hongphucbk/lvthacsi/09. Present/20190629_163446.jpg

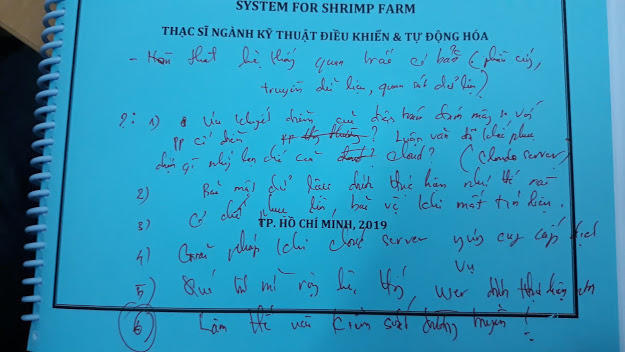
09. Present/20190629_163446.jpg
