hongphucbk/lvthacsi/07. Drawing/BV06.pdf

1 2 3 4 5 6 7 8 1 3 2 FEDCA CBA 4 5 7 6 FE 8 CENINTEC Ngày: 23.08.2018 1:1 MÁY ĐO eAQUA Thiết kế Số S.lg Vẽ Duyệt Số tài liệu Chữ kí Ngày Tờ: 06 Số tờ: 08 Dấu Khối lượng Tỉ lệ Kiểm tra 1 B STT Kí hiệu Tên gọi S.lg Vật liệu Ghi chú L.Đ.CẨN L.Đ.CẨN LÂM NY LÂM NY N1 hoạt động Đèn báo Còi hú Đèn lỗi

# DenHD

Đèn lỗi,Còi sensor độ mặn | pin 1 pin 2 | +24V AI2+ sensor pH | đỏ đen | -12V ⁺¹²V

# D1 sensor pH

D0 sensor pH xanh trắng | ong cấp cho cảm biến pH Note:+12V -12V lấy từ nguồn tổ | PLC Note:+24V lấy từ nguồn 24V của
