hongphucbk/lvthacsi/02. Document Soft/Config.docx

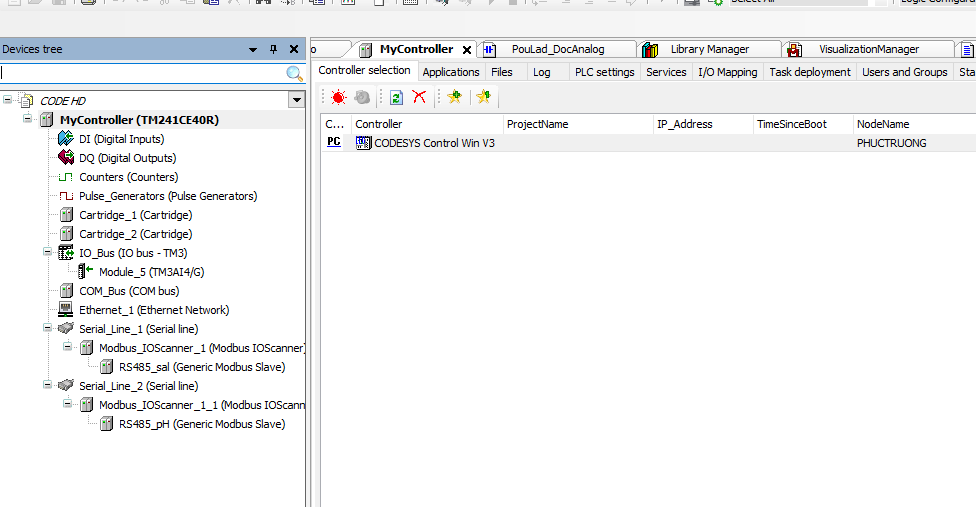
[picture p93: figure]
