hongphucbk/lvthacsi/07. Drawing/BV08.pdf

1 2 3 4 5 6 7 8 1 3 2 FCA CBA 4 5 7 6 FED 8 CENINTEC Ngày: 23.08.2018 1:1 MÁY ĐO eAQUA Thiết kế Số S.lg Vẽ Duyệt Số tài liệu Chữ kí Ngày Tờ: 08 Số tờ: 08 Dấu Khối lượng Tỉ lệ Kiểm tra 1 B STT Kí hiệu Tên gọi S.lg Vật liệu Ghi chú 121110090807060504030201Domino 1 121110090807060504030201Domino 2 VU VU CB_ap CB_ap 0VDC(24) +24VDC 0VDC(24) +24VDC Van XacNhan XacNhan đo 1 đo 1 Van đo 2 Van đo 2 Van đo 5 Van đo 4 Van đo 3 Van đo 5 Van đo 4 Van đo 3 Van Van cấp Van mồi Van đo 8 Van đo 7 Van đo 6 Van rửa Van xả rửa Van xảVan cấp Van mồi Van đo 18 Van đo 7 Van đo 6 Van N0.0 N0 L0.0 L0 L1N1 L1N1 L.Đ.CẨN L.Đ.CẨN LÂM NY LÂM NY domino cho phù hợp. domino,tùy vào cách đi dây mà sử dụng Note: Không nhất thiết phải đấu dây theo

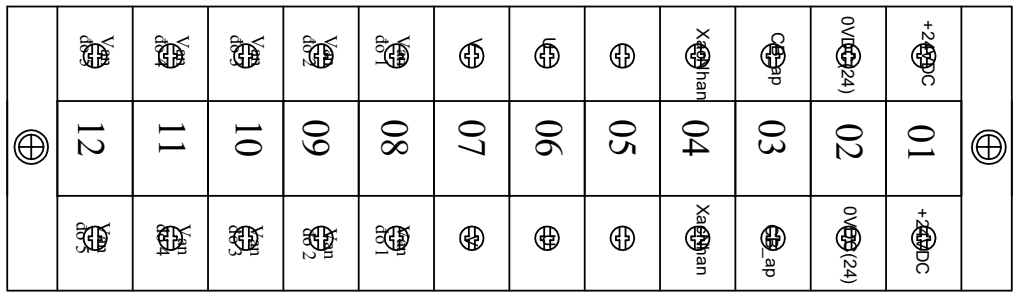
[picture p94: figure]
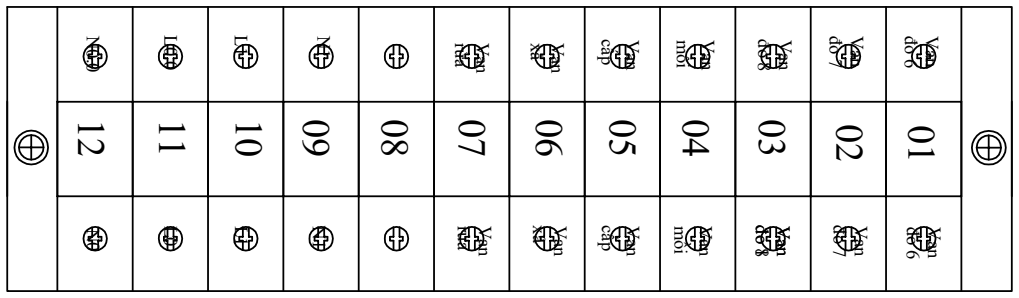
[picture p95: figure]
