hongphucbk/lvthacsi/05. Reports/Thong tin tai khoan.xlsx

MÁY ĐO | IP | WIFI | WIFI | Web điều khiển | App giám sát EQUA | Web giám sát | Phần mềm nuôi tôm
EQUA | 192.168.1.125 | TRANG TRẠI | 192.168.1.1 pass: 12345678 | http://192.168.1.125:8080/maydo.htm | CÓ | http://14.161.37.163:35000/home/ Admin2 pass 123 (http://14.161.37.163:35000/home/%20%20Admin2%20pass%20123)
DCSELAB | 192.168.1.125 | DCSELAB | 192.168.1.1 pass: 12345678 | http://192.168.1.125:8080/dcselab.htm |  |  | dcselab / 123
