hongphucbk/lvthacsi/05. Reports/Do Nh4.JPG

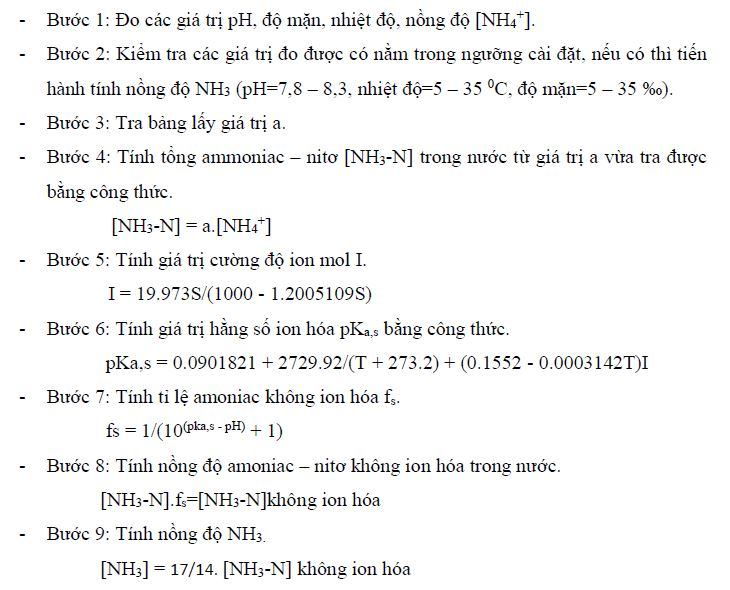
05. Reports/Do Nh4.JPG
