hongphucbk/lvthacsi/(list of files, cad)

Other CAD files:
07. Drawing/bv may do 2652018/MD_MD_7.dwg
07. Drawing/Bản vẽ 26042018/Drumfilter 2d_DR(Cụm động cơ) 03.03.dwg
07. Drawing/bv may do 2652018/MD_MD_5.dwg
07. Drawing/Bản vẽ 26042018/Drumfilter 2d_DR(Cụm động cơ) 03.01.dwg
07. Drawing/bv may do 2652018/MD_MD_3.dwg
07. Drawing/Bản vẽ 26042018/Drumfilter 2d_DR(Cụm khung đỡ và máng cấp thoát) 05.01.dwg
07. Drawing/bv may do 2652018/ban ve tu do.dwg
07. Drawing/Bản vẽ 26042018/Drumfilter 2d_DR(Cụm bơm) 06.00.dwg
07. Drawing/bv may do 2652018/MD_MD_8.dwg
07. Drawing/Bản vẽ 26042018/Drumfilter 2d_DR(Cụm động cơ) 03.02.dwg
07. Drawing/bv may do 2652018/MD_MD_2.dwg
07. Drawing/Bản vẽ 26042018/Drumfilter 2d_DR(Nắp đây) 02.04.dwg
07. Drawing/bv may do 2652018/MD_MD_4.dwg
07. Drawing/Bản vẽ 26042018/Drumfilter 2d_DR(khung) 01.01.dwg
07. Drawing/bv may do 2652018/MD_MD_6.dwg
07. Drawing/Bản vẽ 26042018/Drumfilter 2d_DR(Nắp đây) 02.01.dwg
07. Drawing/bv may do 2652018/MD_MD_1.dwg
07. Drawing/Bản vẽ 26042018/Drumfilter 2d_DR(Cụm động cơ) 03.00.dwg
07. Drawing/Bản vẽ 26042018/Drumfilter 2d_DR(Cụm khung đỡ và máng cấp thoát) 05.04.dwg
07. Drawing/Bản vẽ 26042018/Drumfilter 2d_DR(Nắp đây) 02.02.dwg
07. Drawing/Bản vẽ 26042018/Drumfilter 2d_DR(Nắp đây) 02.03.dwg
07. Drawing/Bản vẽ 26042018/Drumfilter 2d_DR(Khung) 01.00.dwg
07. Drawing/Bản vẽ 26042018/Drumfilter 2d_DR(Cụm trống lọc) 04.00.dwg
07. Drawing/Bản vẽ 26042018/Drumfilter 2d_DR(Cụm khung đỡ và máng cấp thoát) 05.05.dwg
07. Drawing/Bản vẽ 26042018/Drumfilter 2d_DR(Cụm bơm) 06.01.dwg
07. Drawing/Bản vẽ 26042018/Drumfilter 2d_DR(DRUMFILTER) 0.00.dwg
07. Drawing/Bản vẽ 26042018/Drumfilter 2d_DR(Cụm khung đỡ và máng cấp thoát) 05.03.dwg
07. Drawing/Bản vẽ 26042018/Drumfilter 2d_DR(Khung) 01.02.dwg
07. Drawing/Bản vẽ 26042018/Drumfilter 2d_DR(Khung) 01.03.dwg
07. Drawing/Bản vẽ 26042018/Drumfilter 2d_DR(Cụm khung đỡ và máng cấp thoát) 05.00.dwg
