hongphucbk/lvthacsi/07. Drawing/BV02.pdf

D0 sensor pH số 5 là D0 của sensor độ mặn. là D1 của sensor độ mặn,chân RJ45 là cáp ethenet chân số 4 | NC nút dừng khẩn Q7 Q6 Q5 Q4 NC COM0 | Q3 Q2 Q1 Q0 TM2DRA8RT | COM1 | L1.1 Van đo 12 Van đo 11 Van đo 10 Van đo 9

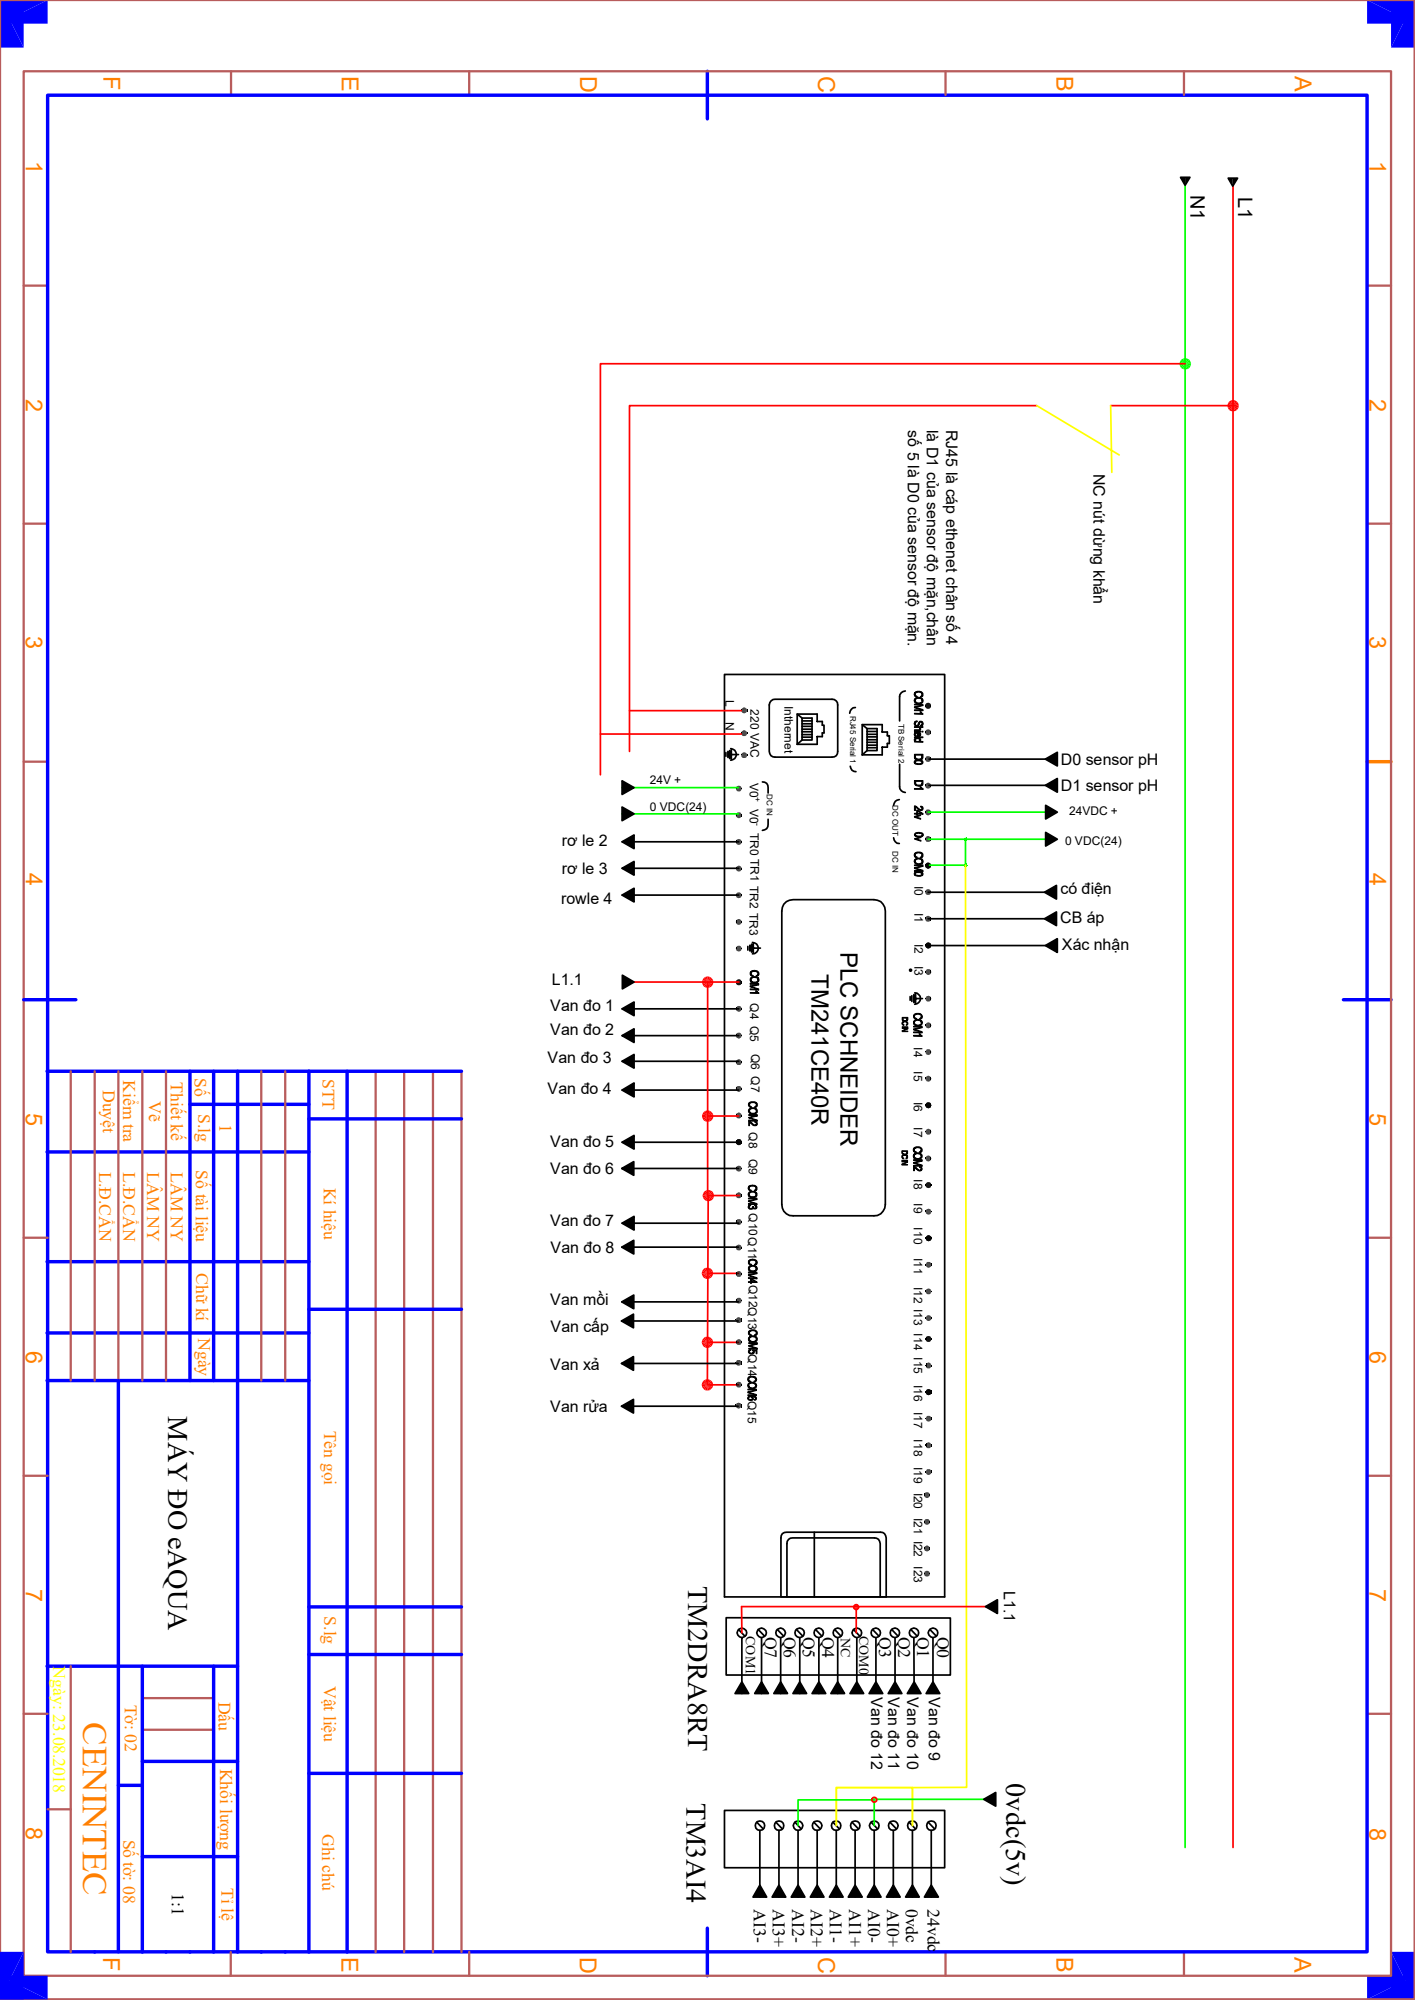
[picture p97: page 1]

1 2 3 4 5 6 7 8 1 3 2 FEDCA CBA 4 5 7 6 FED 8 CENINTEC Ngày: 23.08.2018 1:1 MÁY ĐO eAQUA Thiết kế Số S.lg Vẽ Duyệt Số tài liệu Chữ kí Ngày Tờ: 02 Số tờ: 08 Dấu Khối lượng Tỉ lệ Kiểm tra 1 B STT Kí hiệu Tên gọi S.lg Vật liệu Ghi chú L.Đ.CẨN L.Đ.CẨN LÂM NY LÂM NY L1 PLC SCHNEIDER TM241CE40R V0+ V0- N1
