hongphucbk/lvthacsi/07. Drawing/BV03.pdf

rơ le 2 | L0N0 | RL3
rơ le 4 RL1 | RLNK1

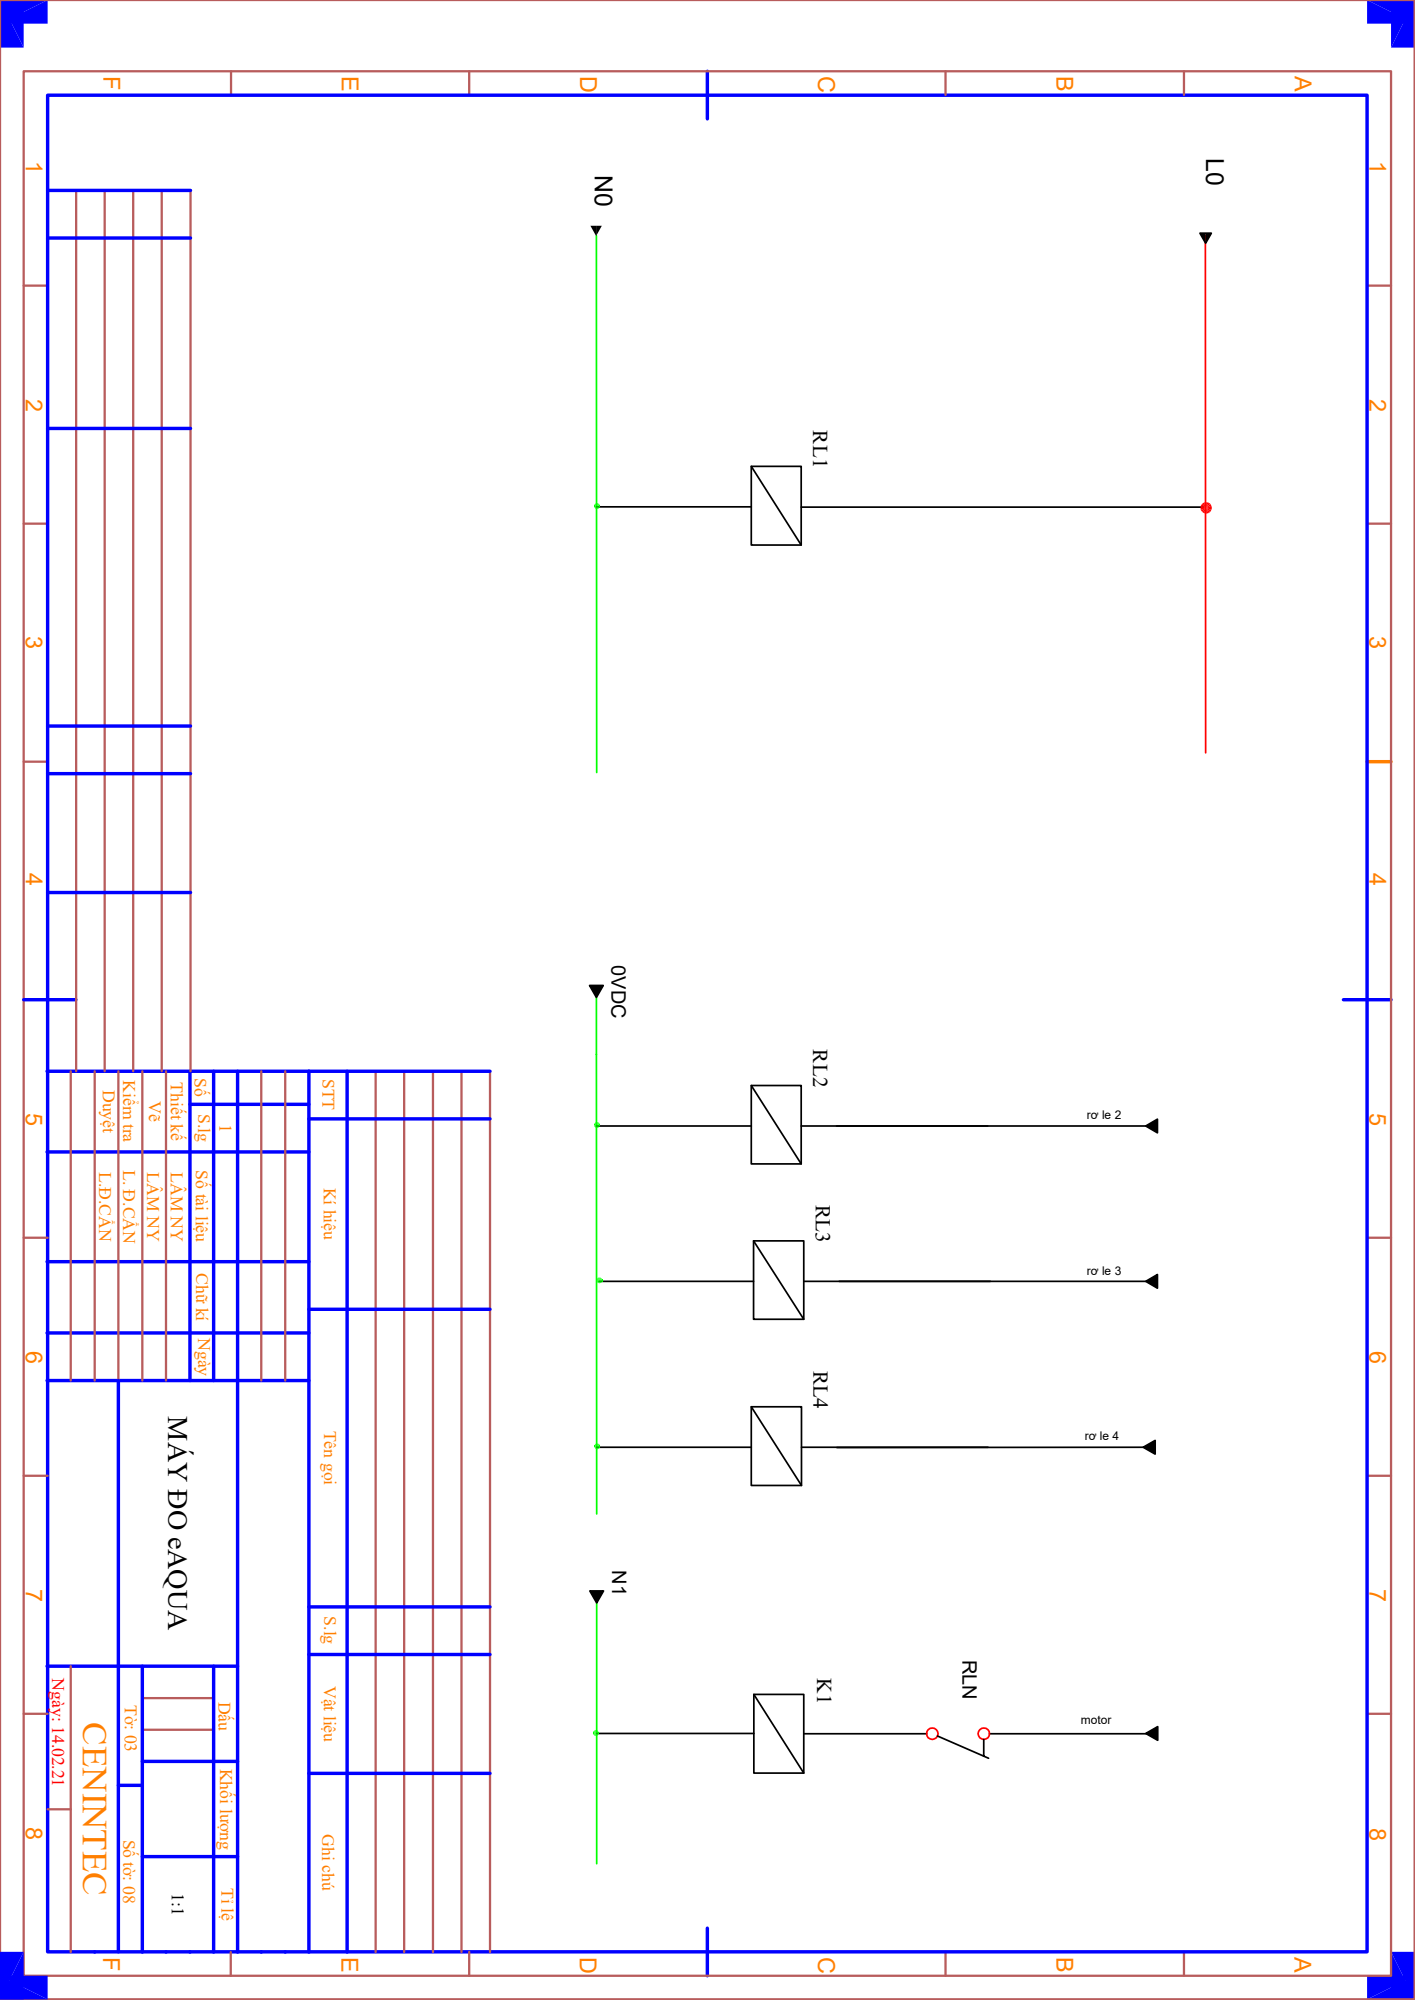
[picture p98: page 1]
motor N1

1 2 3 4 5 6 7 8 1 3 2 FEDCA CBA 4 5 7 6 FED 8 CENINTEC Ngày: 14.02.21 1:1 MÁY ĐO eAQUA Thiết kế Số S.lg Vẽ Duyệt Số tài liệu Chữ kí Ngày Tờ: 03 Số tờ: 08 Dấu Khối lượng Tỉ lệ Kiểm tra 1 B STT Kí hiệu Tên gọi S.lg Vật liệu Ghi chú L.Đ.CẨN L. Đ.CẨN LÂM NY LÂM NY 0VDC RL2
