hongphucbk/lvthacsi/07. Drawing/BV04.pdf

có điện | RL2
Motor | 24V +

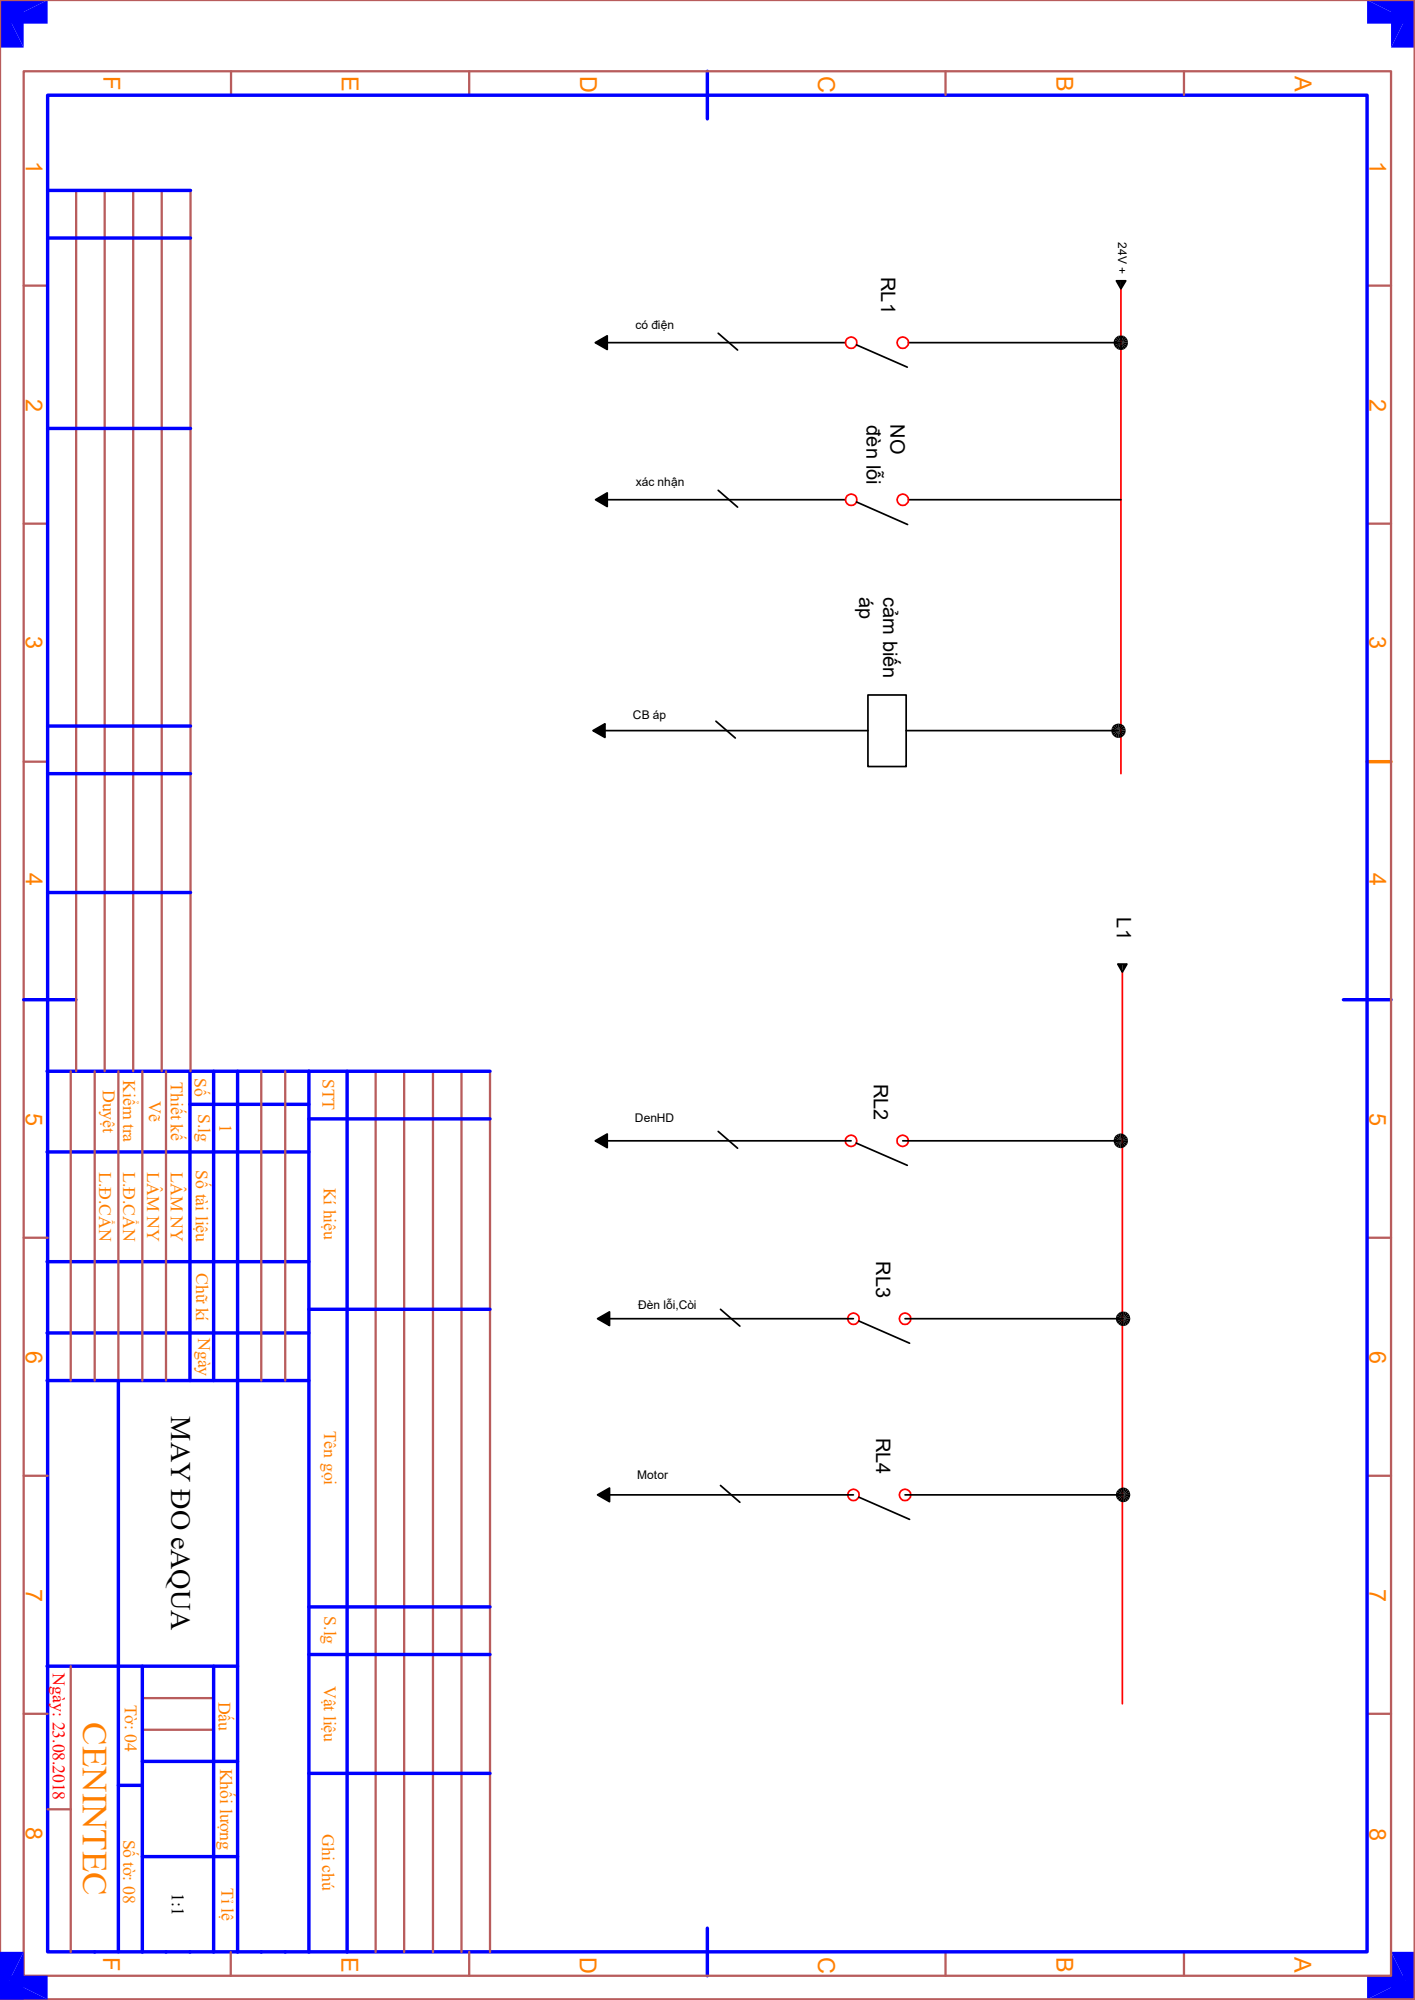
[picture p99: page 1]
DenHD; Đèn lỗi,Còi; ápcảm biến đèn lỗi NO; xác nhận

1 2 3 4 5 6 7 8 1 3 2 FEDCA CBA 4 5 7 6 FED 8 CENINTEC Ngày: 23.08.2018 1:1 MAY ĐO eAQUA Thiết kế Số S.lg Vẽ Duyệt Số tài liệu Chữ kí Ngày Tờ: 04 Số tờ: 08 Dấu Khối lượng Tỉ lệ Kiểm tra 1 B STT Kí hiệu Tên gọi S.lg Vật liệu Ghi chú L.Đ.CẨN L.Đ.CẨN LÂM NY LÂM NY L1 RL1
