hongphucbk/lvthacsi/07. Drawing/BV05.pdf

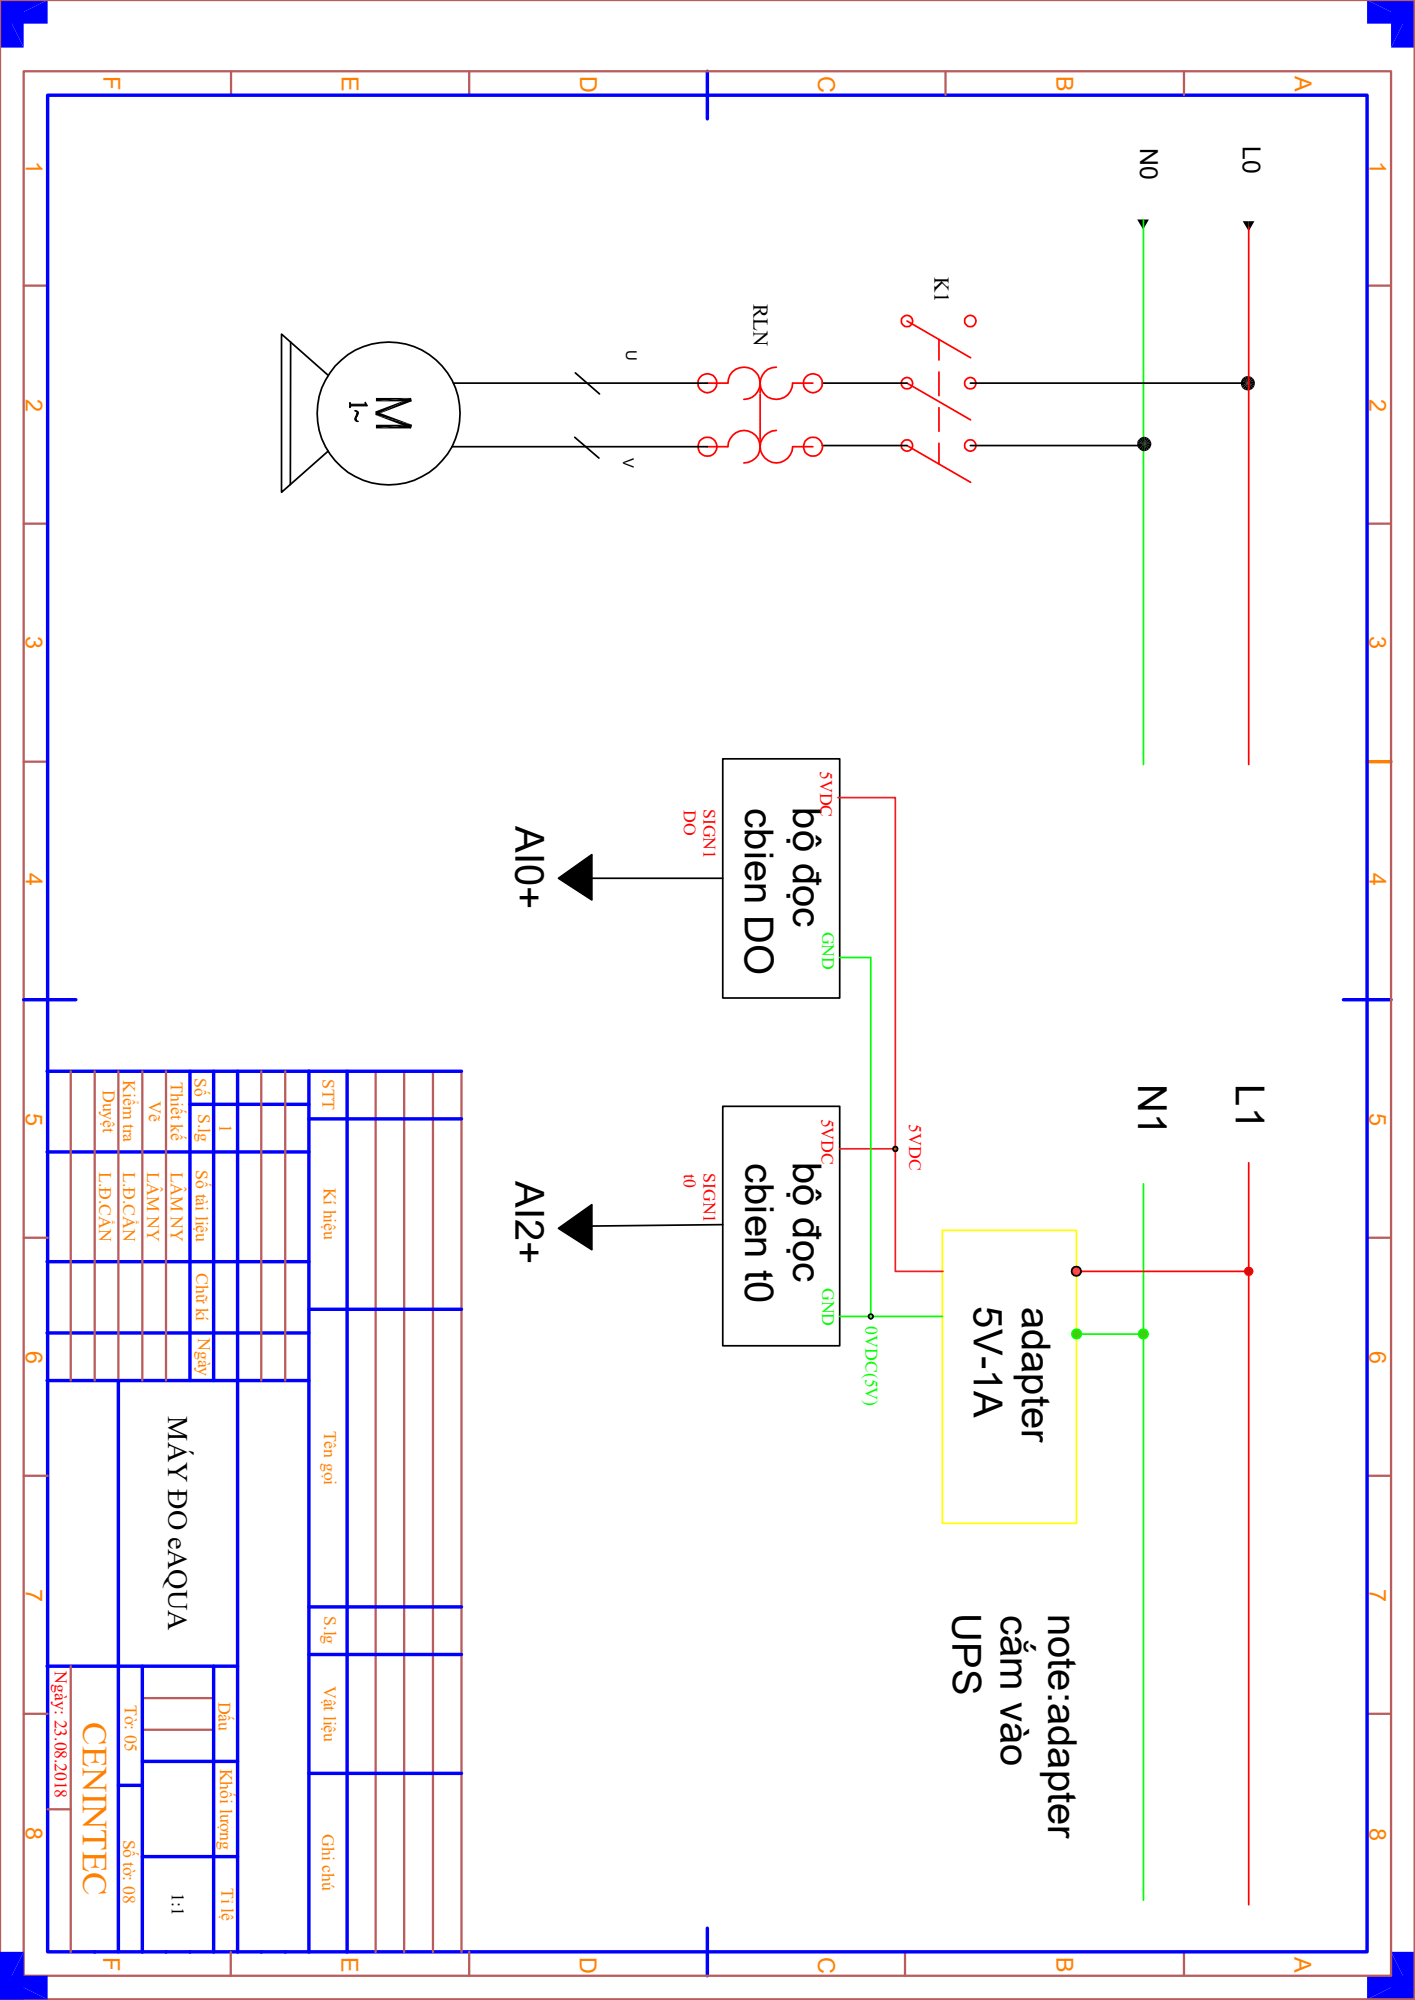
[picture p100: page 1]

1 2 3 4 5 6 7 8 1 3 2 FEDCA CBA 4 5 7 6 FED 8 CENINTEC Ngày: 23.08.2018 1:1 MÁY ĐO eAQUA Thiết kế Số S.lg Vẽ Duyệt Số tài liệu Chữ kí Ngày Tờ: 05 Số tờ: 08 Dấu Khối lượng Tỉ lệ Kiểm tra 1 B STT Kí hiệu Tên gọi S.lg Vật liệu Ghi chú L.Đ.CẨN L.Đ.CẨN LÂM NY LÂM NY N0 L0 K1RLN U V 5V-1A adapter N1 L15VDC 0VDC(5V) cbien DO bộ đọc cbien t0 bộ đọc AI0+ AI2+ 5VDC GND DOSIGN1 5VDC GND t0SIGN1 UPS cắm vào note:adapter
