hongphucbk/lvthacsi/07. Drawing/19.01.27 Tập bản vẽ máy đo e-AQUA.pdf

C
7 M⁸

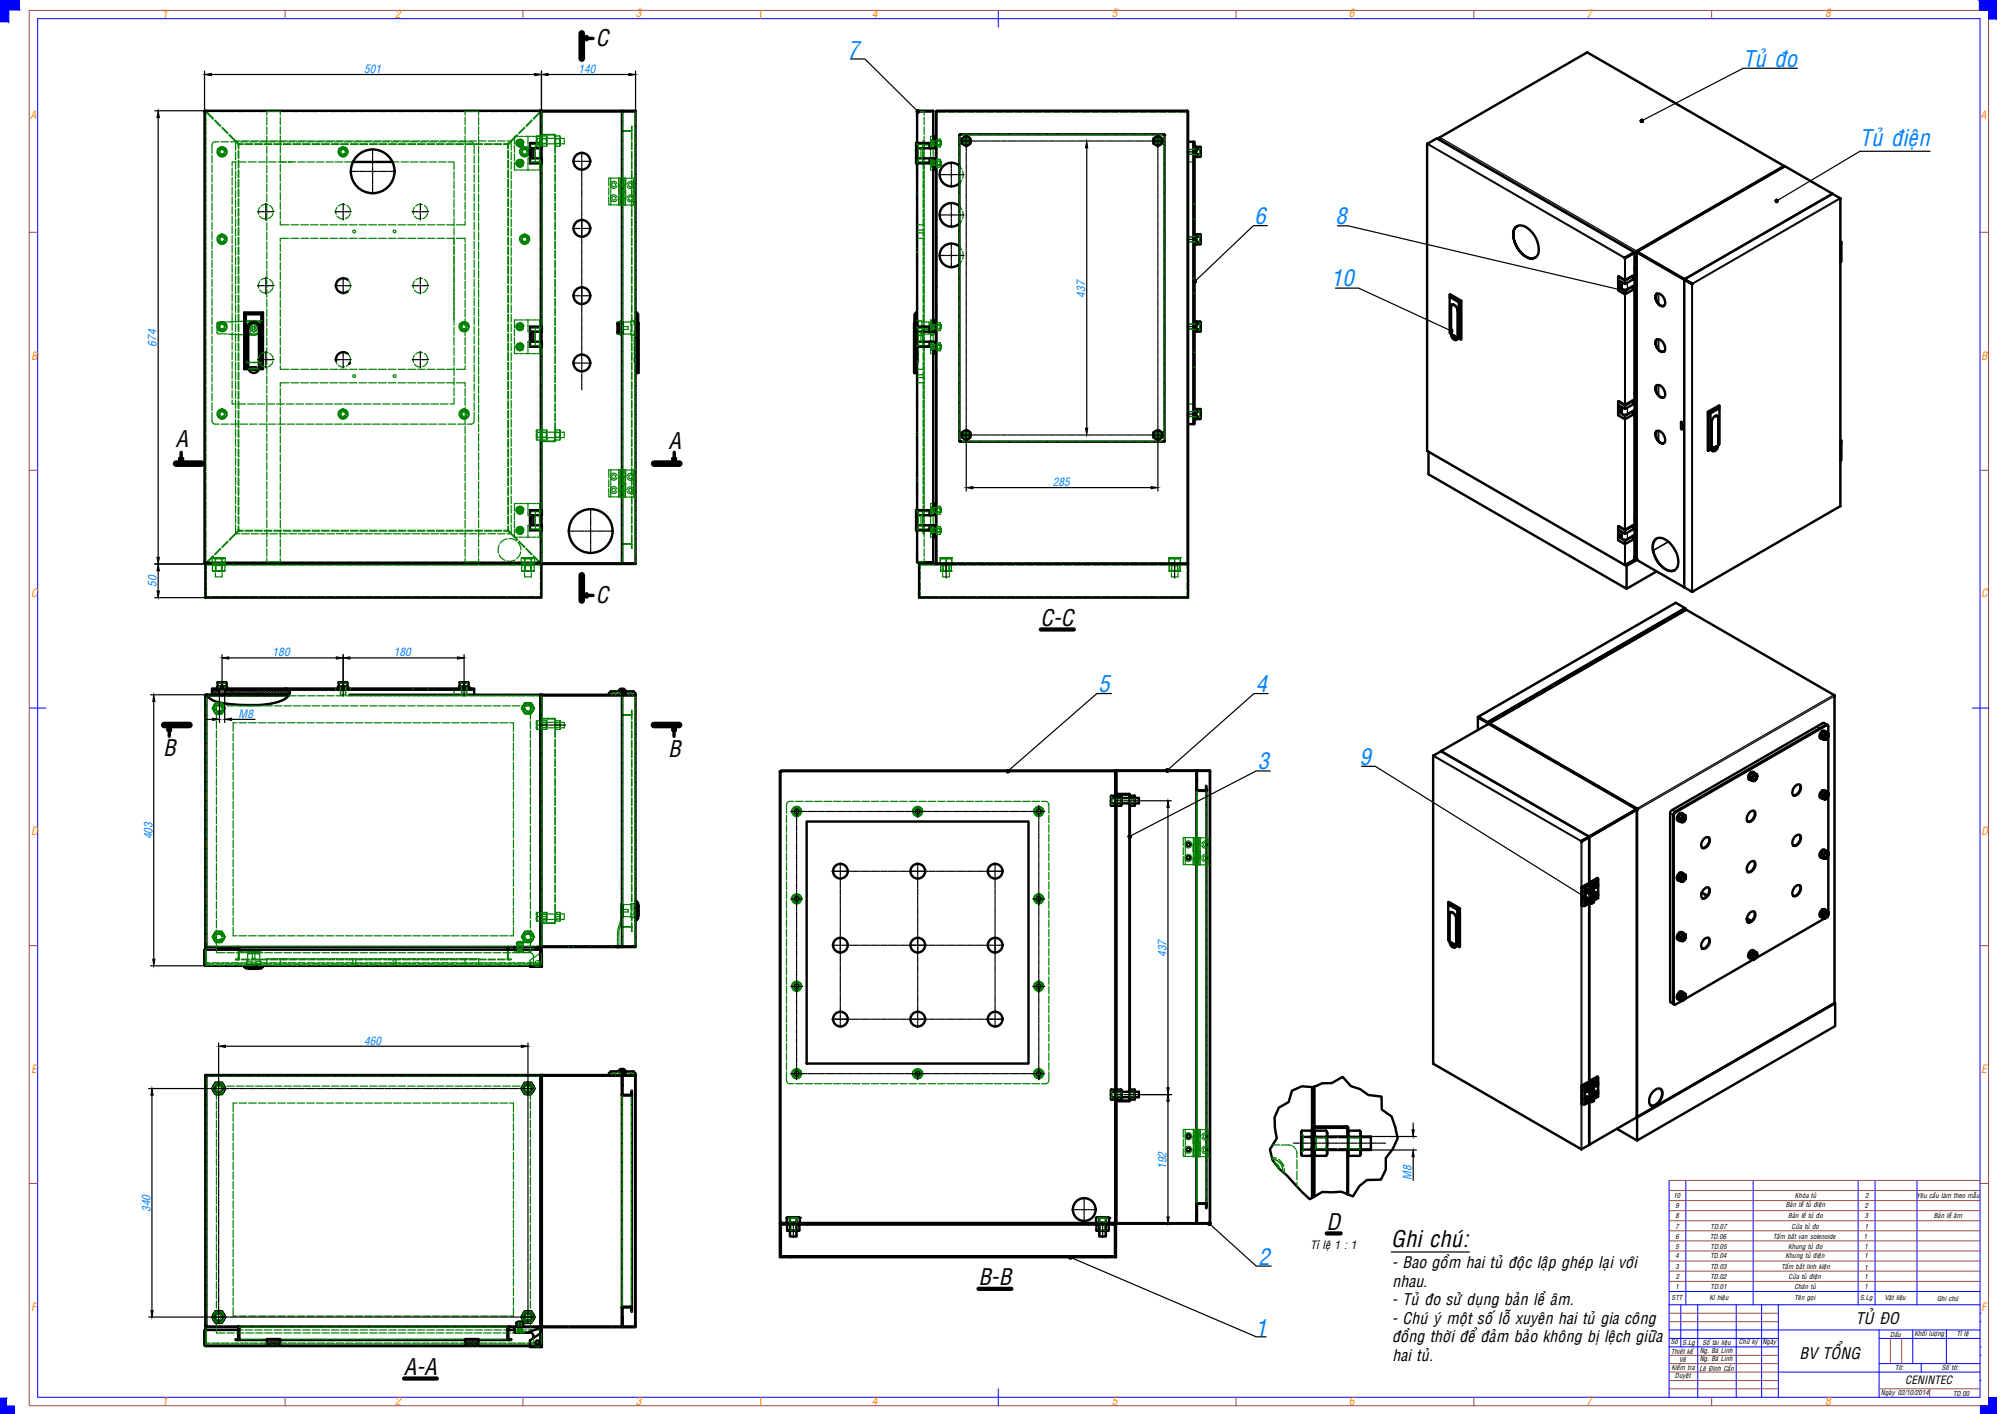
[picture p101: page 1]
Ngaøy; Taám baét van solenoide; A-A ³⁴⁰; Tæ leä 1 : 1 2; Baûn leà tuû ñieän; 2 Ghi chuù:; Tuû ño; Tuû ñieän; Khoùa tuû; Yeâu caàu laøm theo maãu

8 | | Baûn leà tuû ño | 3 | Baûn leà aâm
7 | TD.07 | Cöûa tuû ño | 1

- Bao goàm hai tuû ñoäc laäp gheùp laïi vôùi
nhau.
- Tuû ño söû duïng baûn leà aâm.
- Chuù yù moät soá loã xuyeân hai tuû gia coâng
ñoàng thôøi ñeå ñaûm baûo khoâng bò leäch giöõa
hai tuû.

5 | TD.05 | Khung tuû ño | 1
4 | TD.04 | Khung tuû ñieän | 1
3 | TD.03 | Taám baét linh kieän | 1
2 | TD.02 | Cöûa tuû ñieän | 1
1 | TD.01 | Chaân tuû | 1
STT | Kí hieäu | Teân goïi | S.Lg | Vaät lieäu | Ghi chuù

TUÛ ÑO

BV TOÅNG | Daáu | Khoái löôïng | Tæ leä

Soá S.Lg | Soá taøi lieäu Ng. Baù Linh Ng. Baù Linh | Chöõ kyù | Ngaøy Thieát keá Veõ Kieåm tra Duyeät

Leâ Ñình Caån | | | Tôø: | Soá tôø: CENINTEC

3 | 4 | 5 | 6 | 7 | 8

B

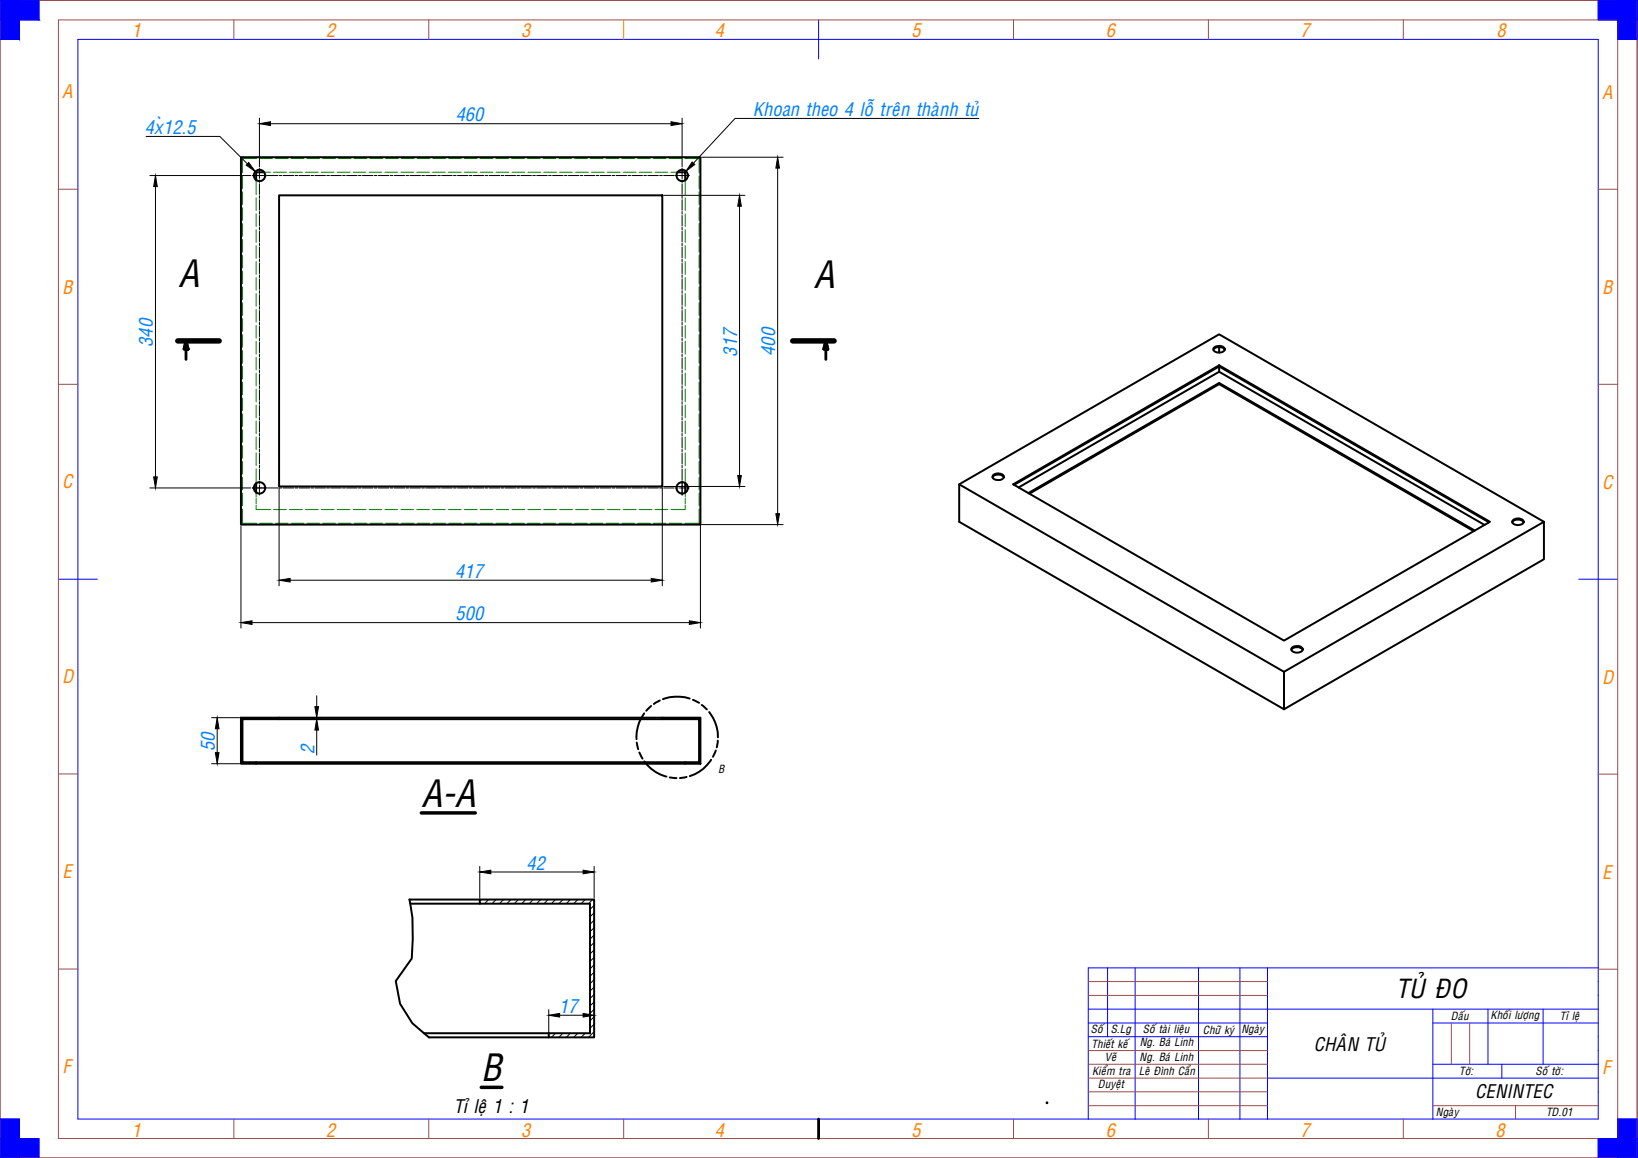
[picture p102: page 2]
Thieát keá; Tæ leä 1 : 1

Khoan theo 4 loã treân thaønh tuû

TUÛ ÑO

CHAÂN TUÛ | Daáu | Khoái löôïng | Tæ leä

Soá | S.Lg | Soá taøi lieäu | Chöõ kyù | Ngaøy

Ng. Baù Linh

Veõ | Ng. Baù Linh
Kieåm tra | | Tôø: | Soá tôø:
Duyeät | | CENINTEC

B

B

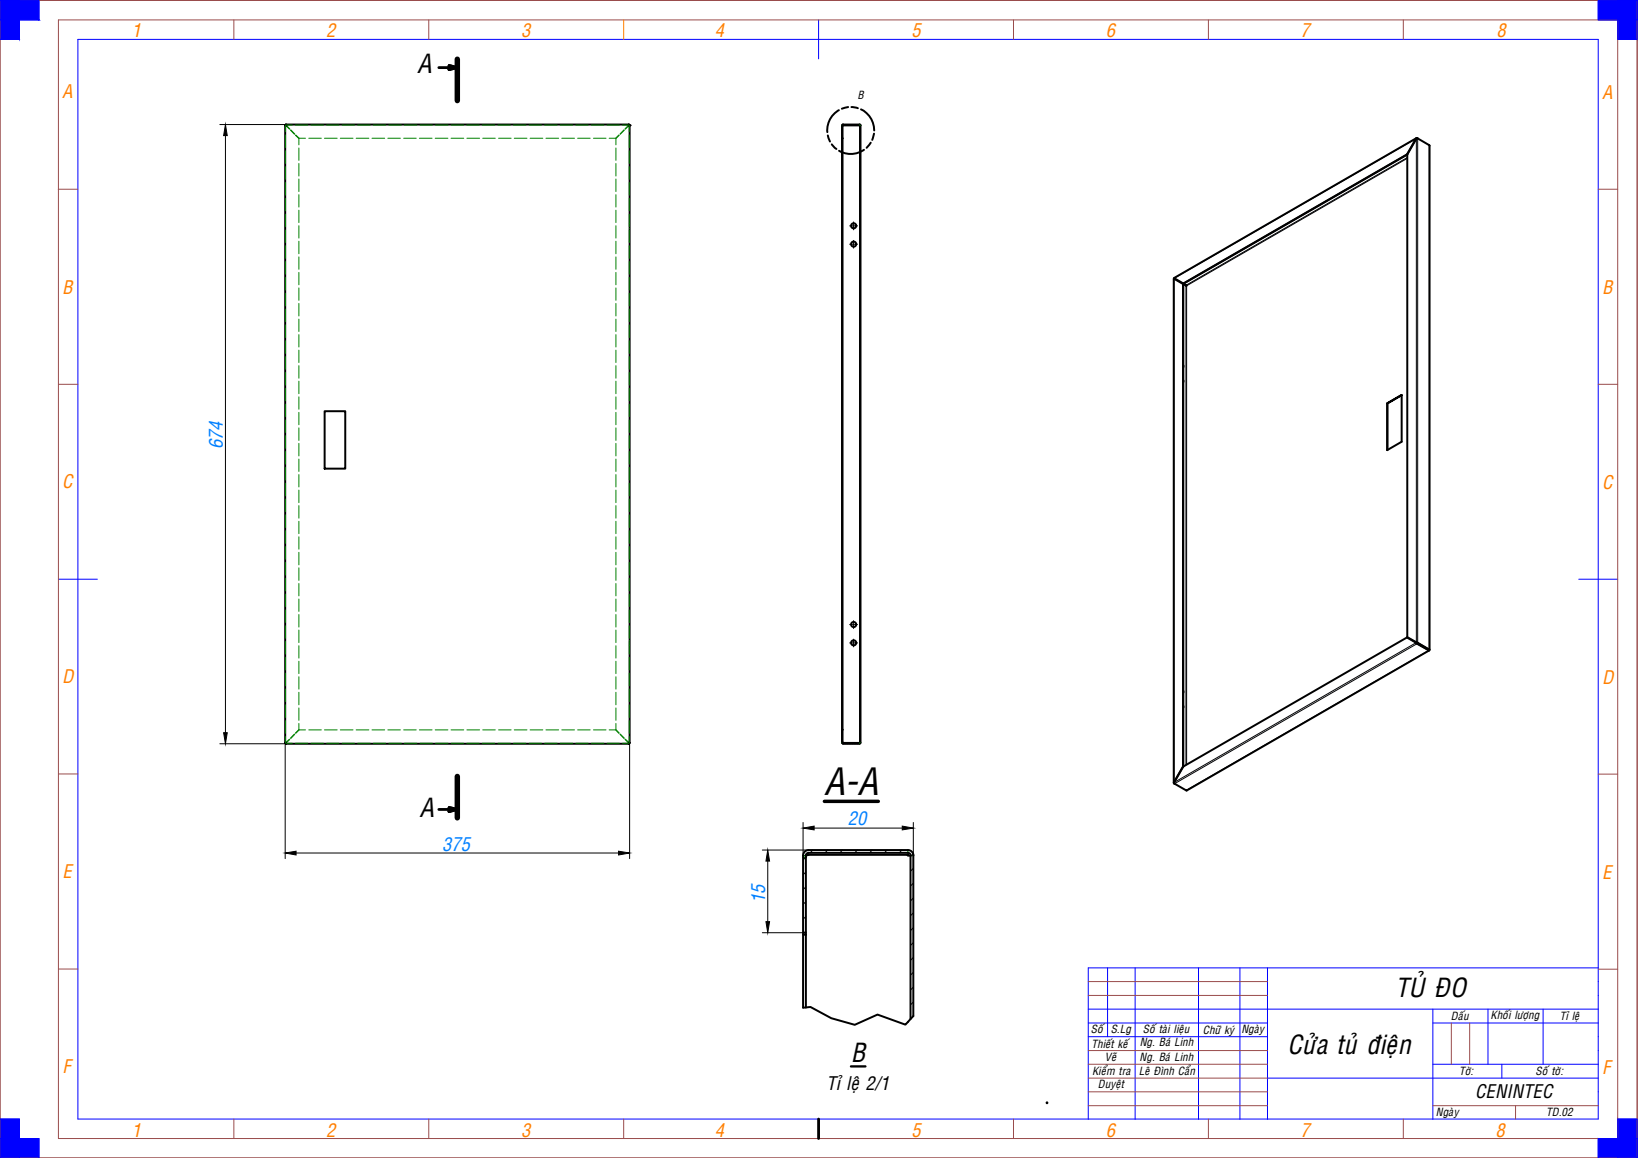
[picture p103: page 3]
A-A ⁶⁷⁴; Tæ leä 2/1

TUÛ ÑO

Cöûa tuû ñieän | Daáu | Khoái löôïng | Tæ leä

Soá | S.Lg | Soá taøi lieäu | Chöõ kyù | Ngaøy
Thieát keá | | Ng. Baù Linh
Veõ | | Ng. Baù Linh

B

B

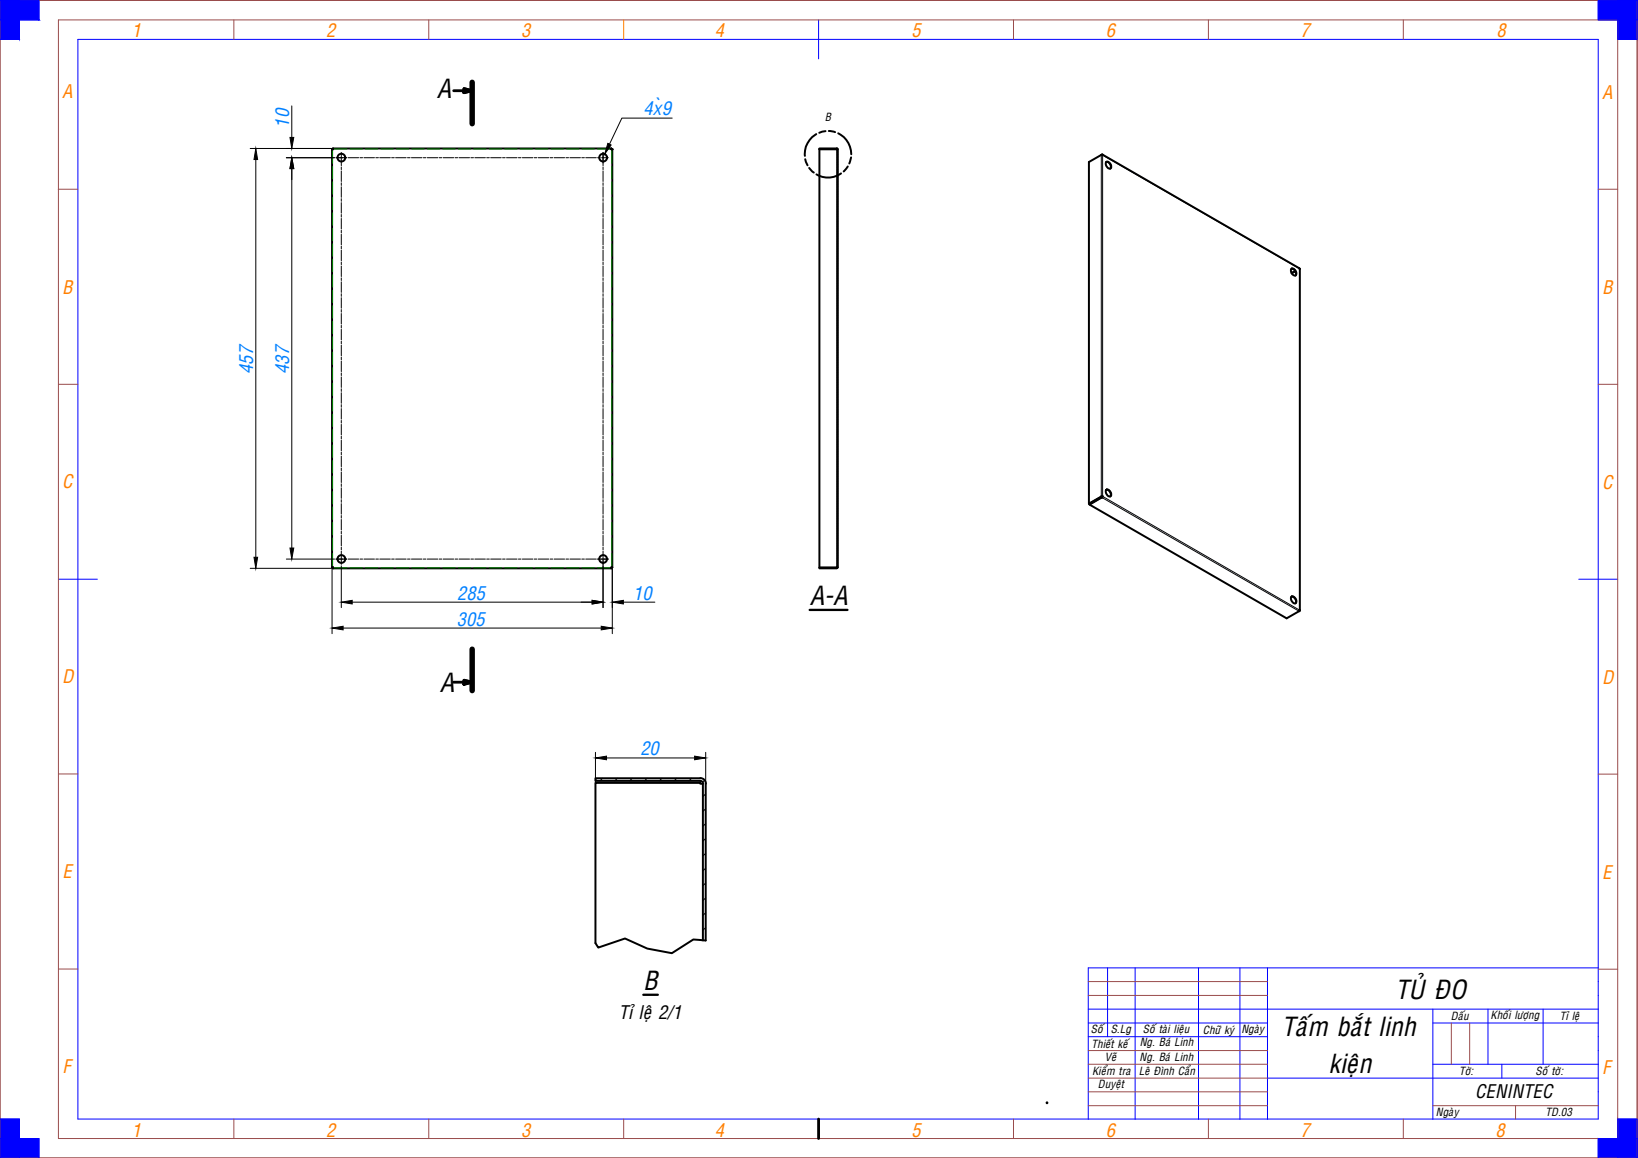
[picture p104: page 4]
305 ⁴⁵⁷ 437; Tæ leä 2/1

TUÛ ÑO

Taám baét linh kieän | Daáu | Khoái löôïng | Tæ leä

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

B

B

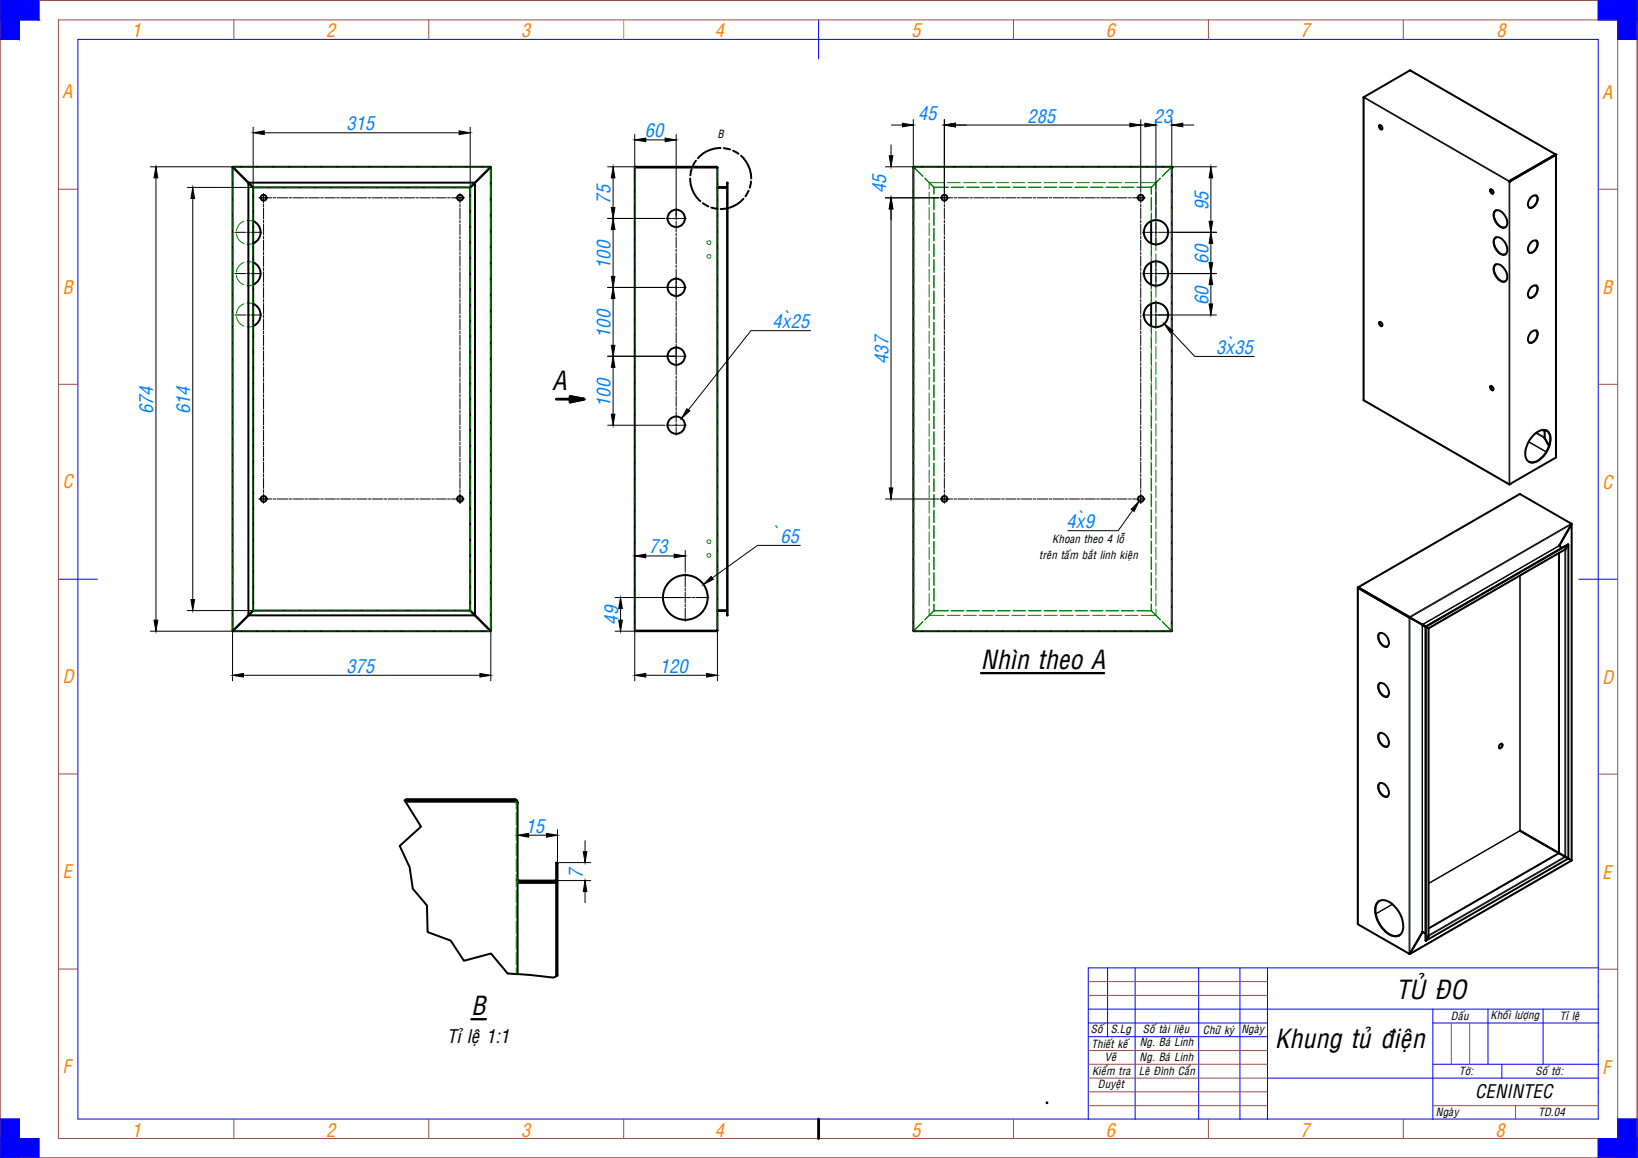
[picture p105: page 5]
375 ⁶⁷⁴ 6¹4; Nhìn theo A; Tæ leä 1:1

Khoan theo 4 loã
treân taám baét linh kieän

TUÛ ÑO

Khung tuû ñieän | Daáu | Khoái löôïng | Tæ leä

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

1 | 8 3 | 4 | 5 | 6 | 7 | 8 4 2 | AB 7 | C 1 ACDE | 6 | E BF | 2 | 3 | D 5 | F
500 67⁴ | C | C

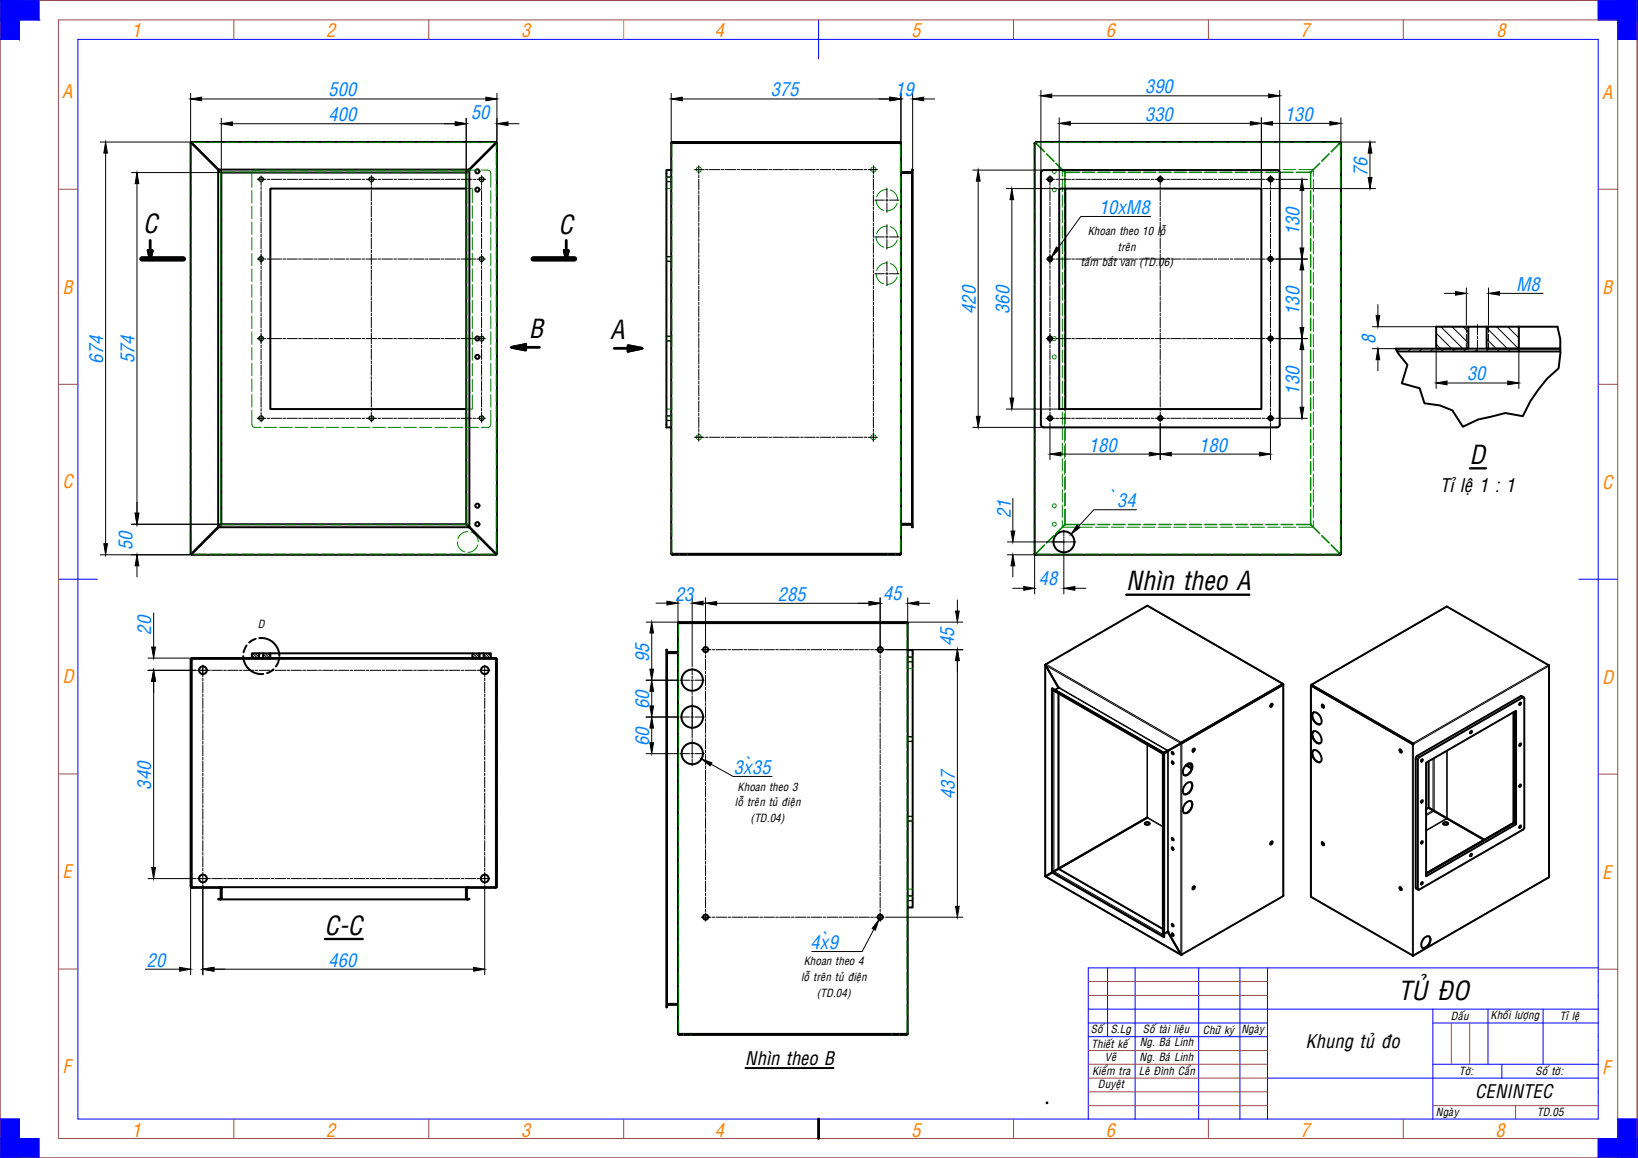
[picture p106: page 6]
Nhìn theo A A; Nhìn theo B B; Tæ leä 1 : 1 ⁸; Khoan theo 10 loã; treân

taám baét van (TD.06)

Khoan theo 3
loã treân tuû ñieän

Khoan theo 4

TUÛ ÑO

Khung tuû ño | Daáu | Khoái löôïng | Tæ leä

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

B

B

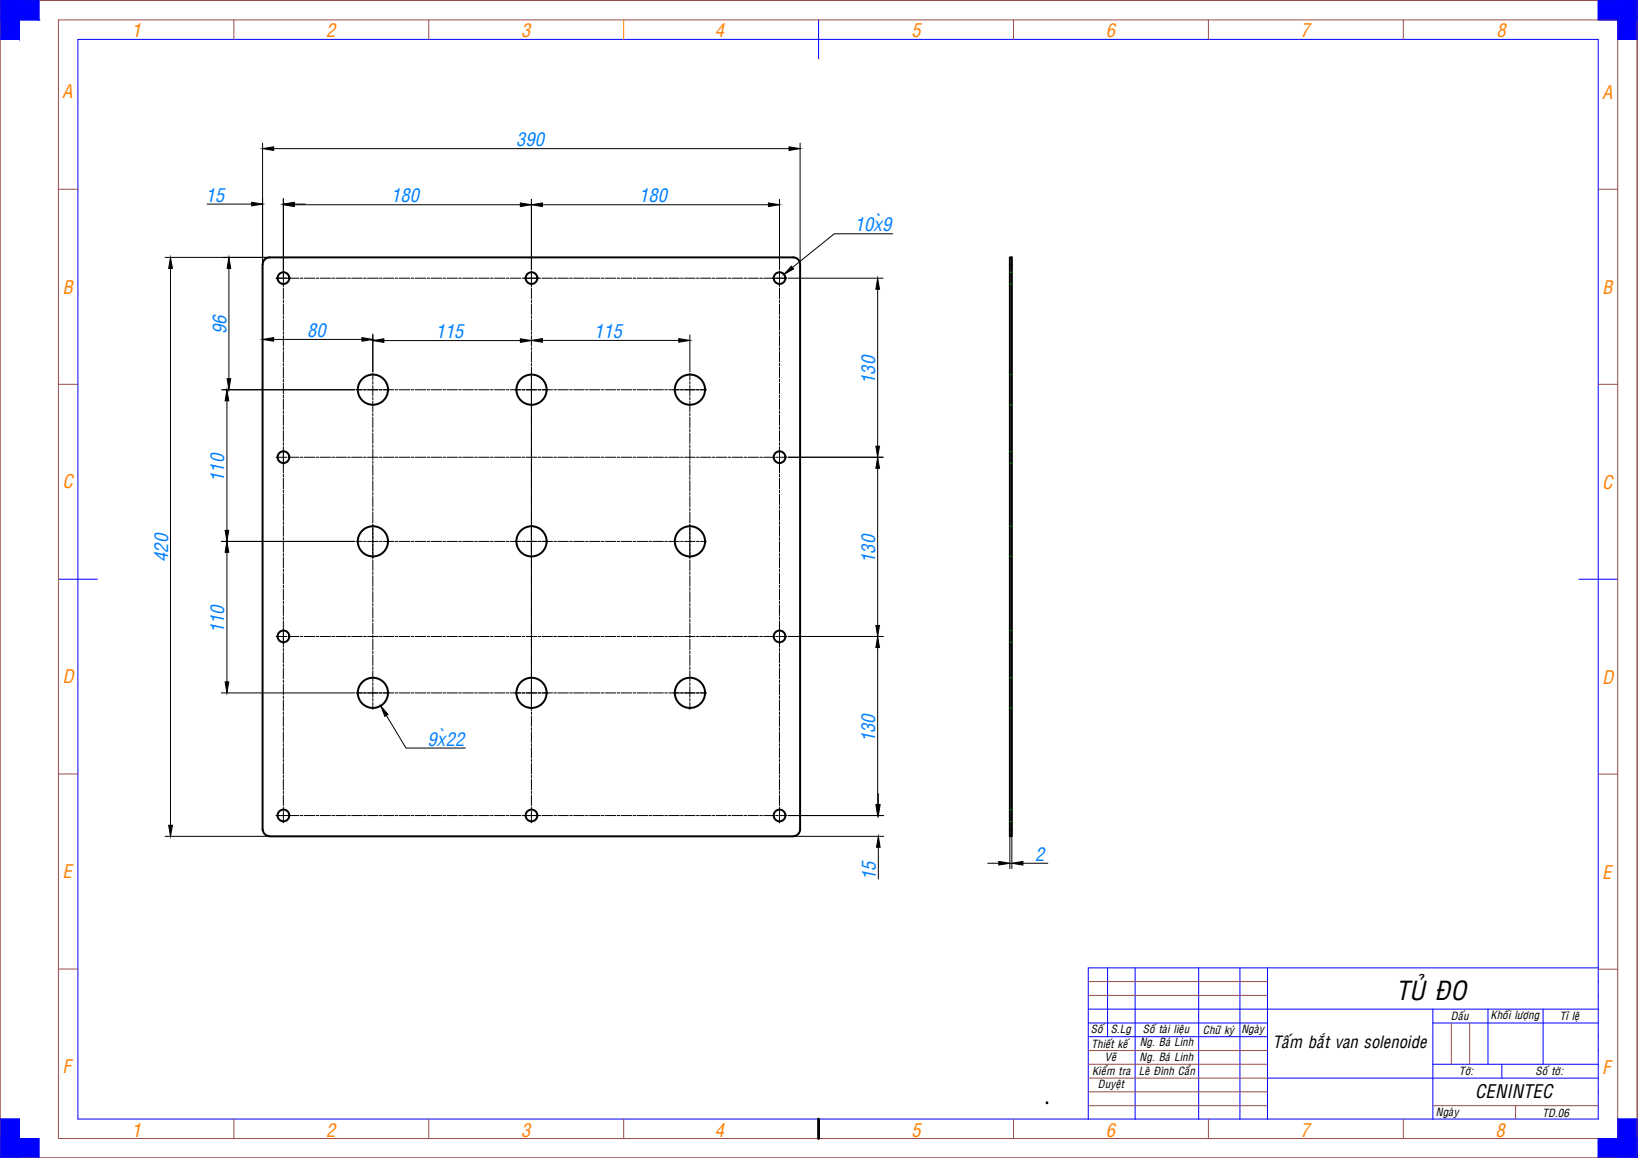
[picture p107: page 7]

TUÛ ÑO

Taám baét van solenoide | Daáu | Khoái löôïng | Tæ leä

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

B

B

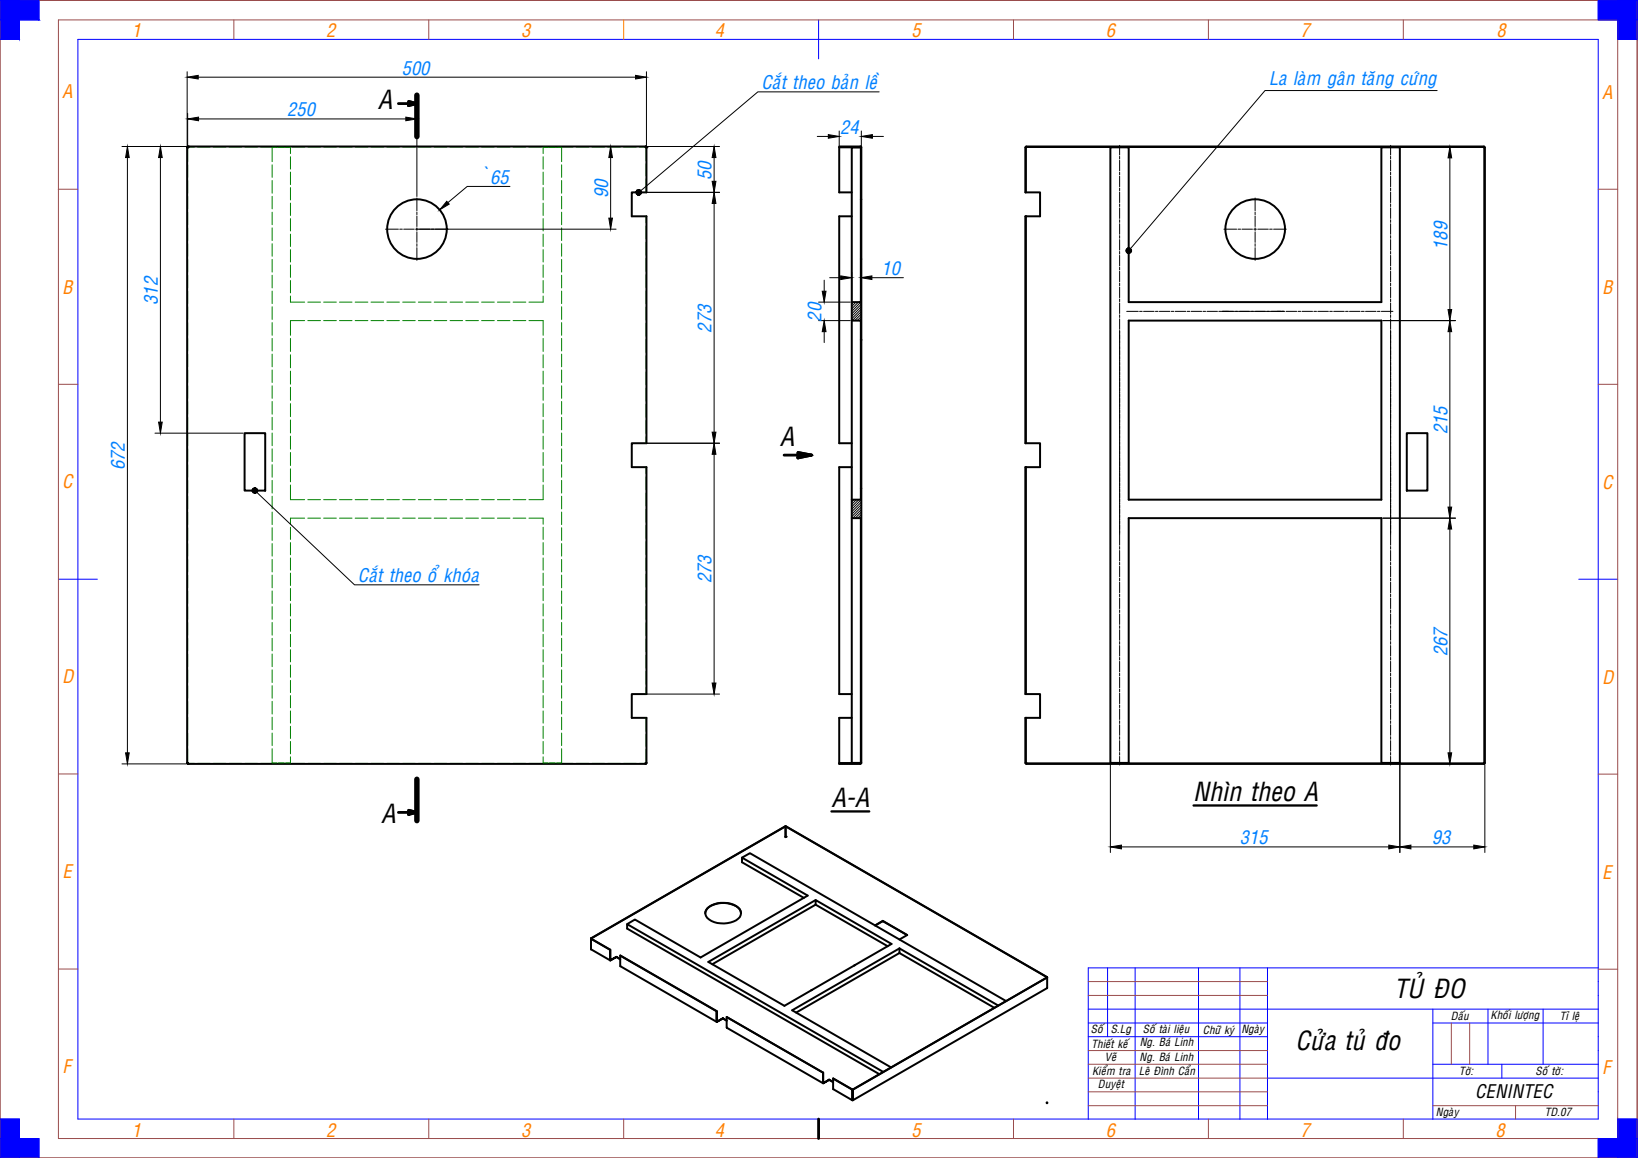
[picture p108: page 8]
Nhìn theo A; Caét theo oå khoùa

La laøm gaân taêng cöùng 20

Caét theo baûn leà 50 273

TUÛ ÑO

Cöûa tuû ño | Daáu | Khoái löôïng | Tæ leä

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
