hongphucbk/lvthacsi/07. Drawing/BV01 Cap nguon den Role.pdf

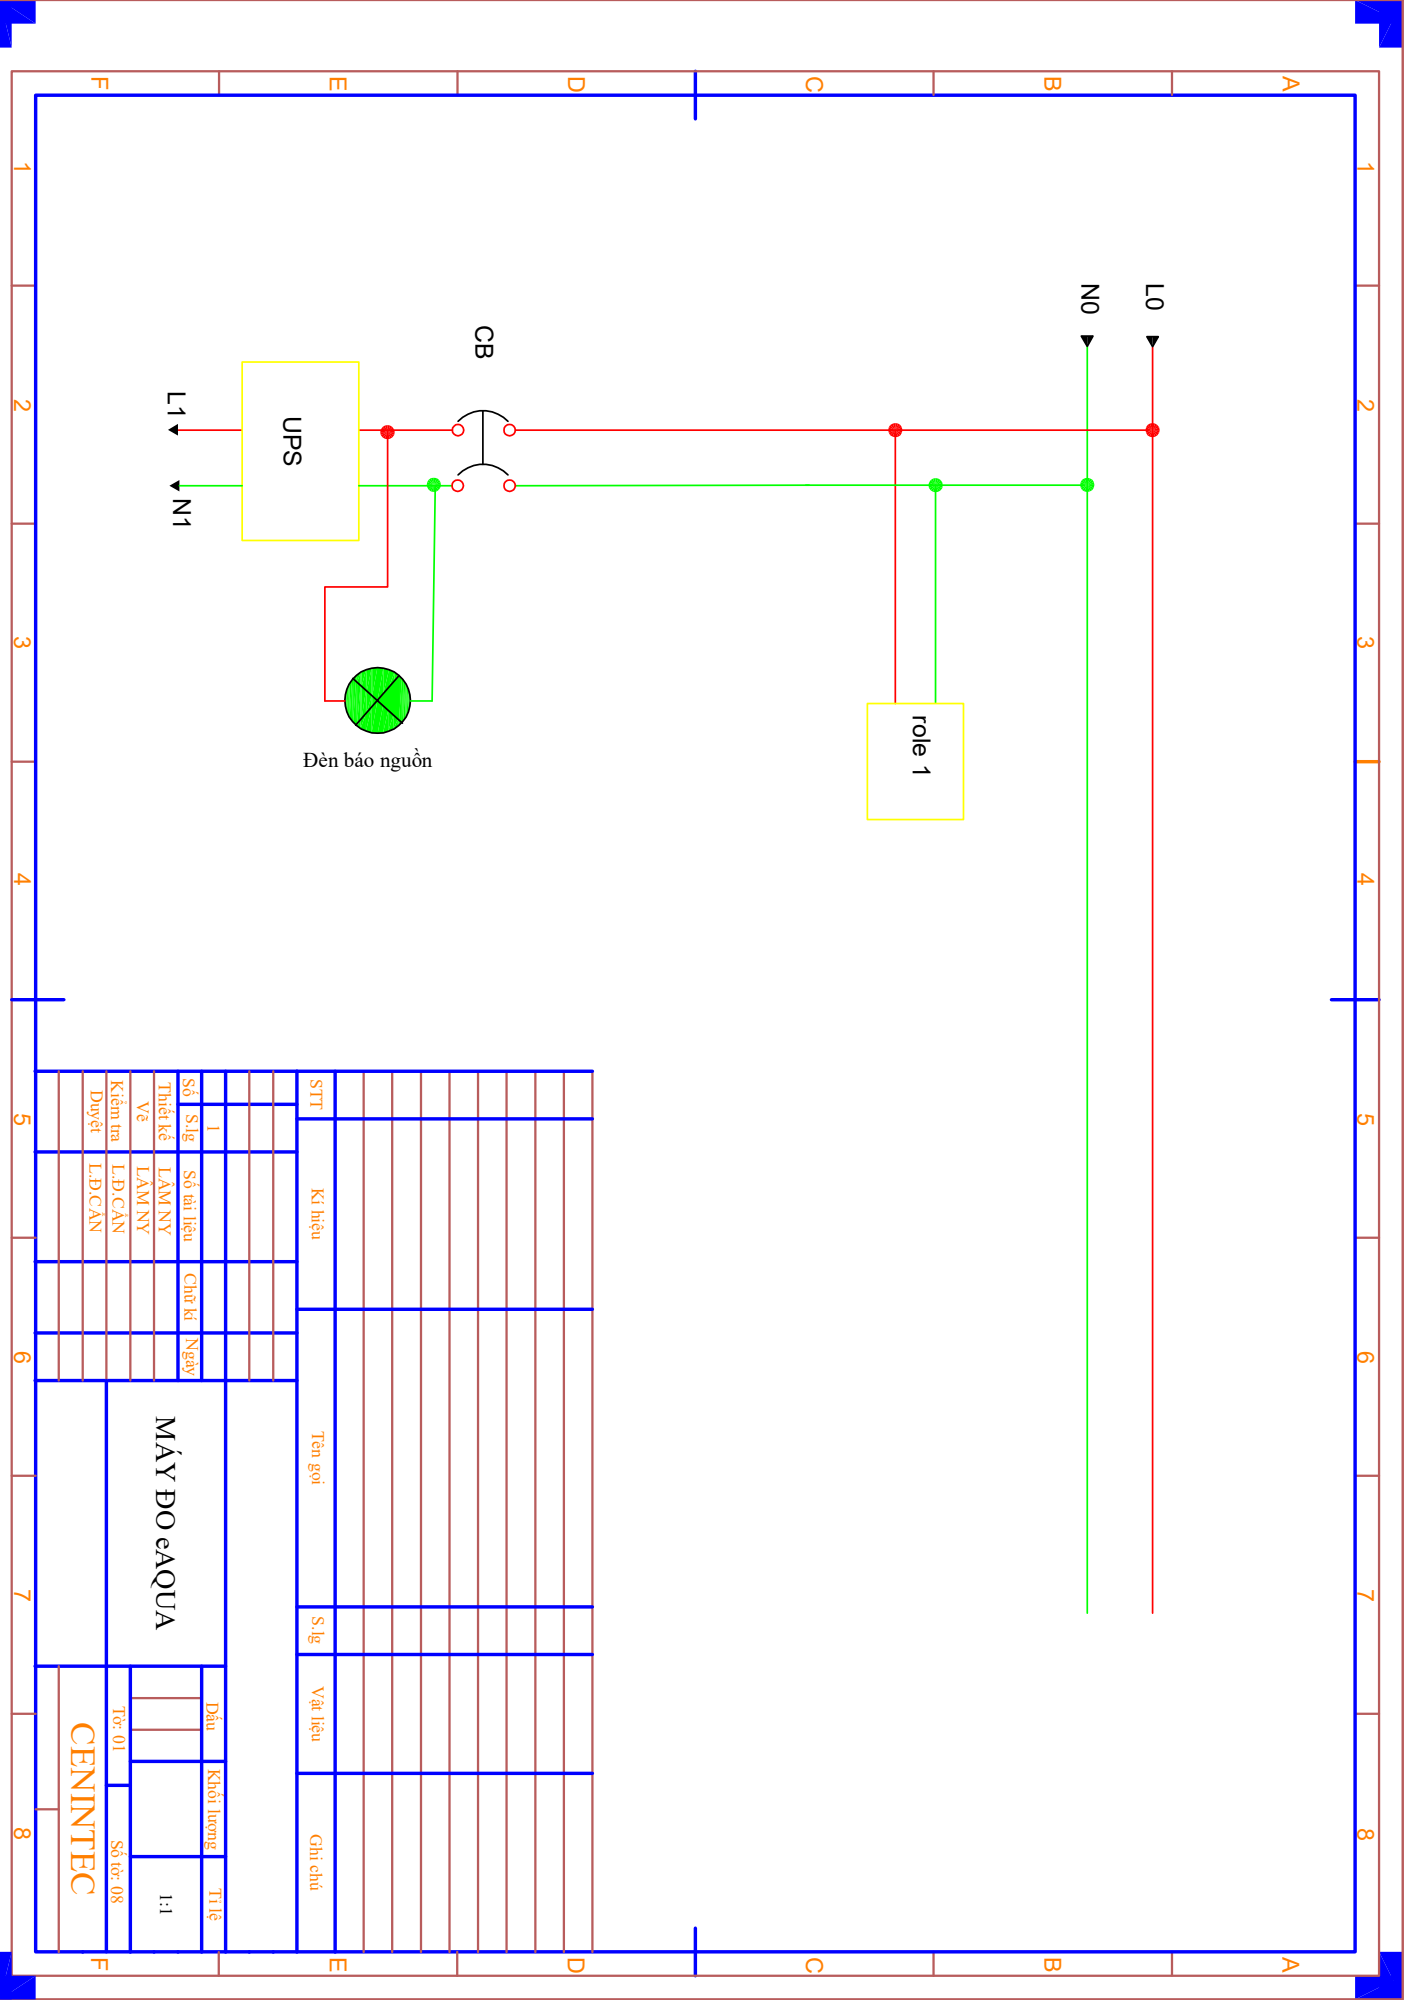
[picture p109: page 1]

1 2 3 4 5 6 7 8 1 3 2 FEDCA CBA 4 5 7 6 FED 8 1:1 MÁY ĐO eAQUA Thiết kế Số S.lg Vẽ Duyệt Số tài liệu Chữ kí Ngày Tờ: 01 Số tờ: 08 Dấu Khối lượng Tỉ lệ Kiểm tra 1 B STT Kí hiệu Tên gọi S.lg Vật liệu Ghi chú CENINTEC N0 L0 CB N1 L1UPS role 1Đèn báo nguồn L.Đ.CẨN L.Đ.CẨN LÂM NY LÂM NY
