hongphucbk/lvthacsi/07. Drawing/BV07.pdf

# Van 2

# Van 3

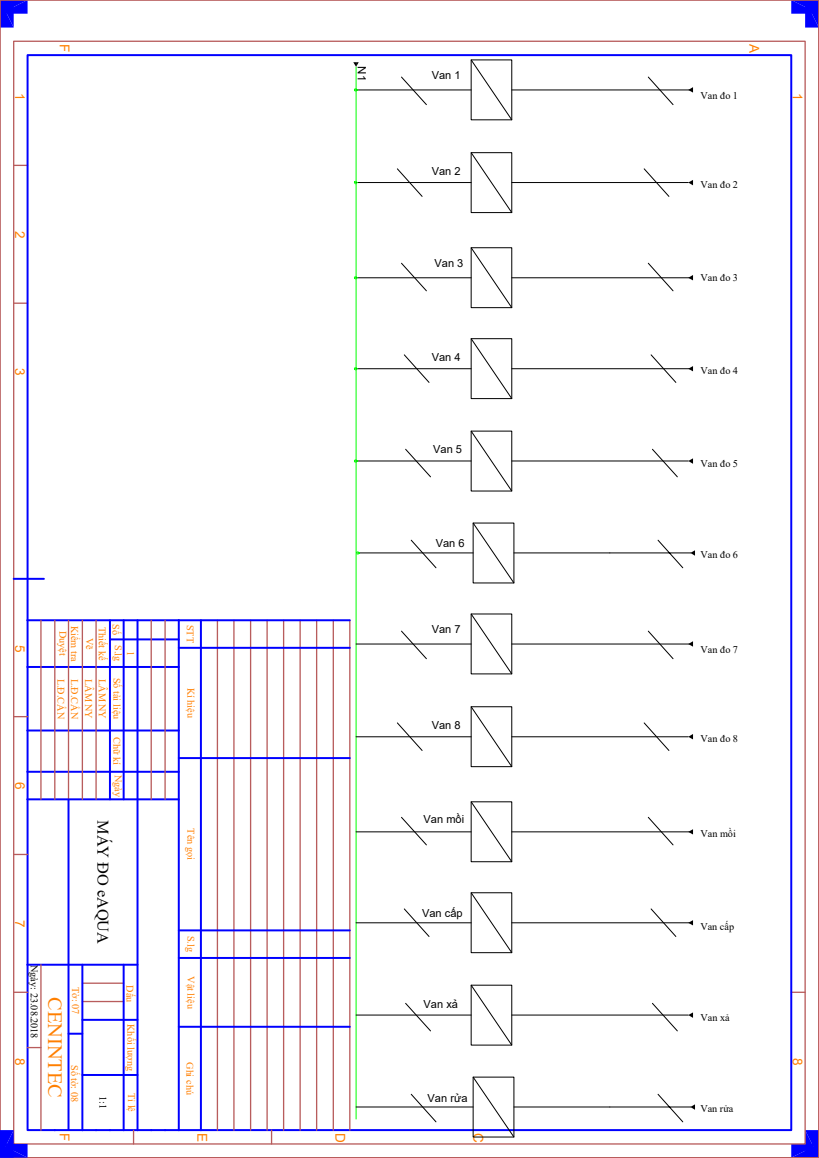
[picture p110: page 1]
N1Van 1; Van 4; Van 5; Van 6; CENINTEC Ngày: 23.08.2018; 1:1 MÁY ĐO eAQUA Thiết kế; Số S.lg Vẽ Duyệt; Số tài liệu Chữ kí Ngày Tờ: 07 Số tờ: 08; Dấu Khối lượng Tỉ lệ Kiểm tra; STT Kí hiệu Tên gọi S.lg Vật liệu Ghi chú L.Đ.CẨN L.Đ.CẨN; LÂM NY; Van đo 1; Van đo 2; Van đo 3; Van đo 4; Van đo 5; Van đo 6; Van 7; Van 8; Van mồi; Van cấp; Van xả; Van rửa; Van đo 7; Van đo 8
