hongphucbk/lvthacsi/(commit log)

2019-03-31 add ch2
    [Drumfilter 2d_DR(Cụm bơm) 06.00.dwg, Drumfilter 2d_DR(Cụm bơm) 06.01.dwg, Drumfilter 2d_DR(Cụm khung đỡ và máng cấp thoát) 05.00.dwg, Drumfilter 2d_DR(Cụm khung đỡ và máng cấp thoát) 05.01.dwg, Drumfilter 2d_DR(Cụm khung đỡ và máng cấp thoát) 05.03.dwg, Drumfilter 2d_DR(Cụm khung đỡ và máng cấp thoát) 05.04.dwg, Drumfilter 2d_DR(Cụm khung đỡ và máng cấp thoát) 05.05.dwg, Drumfilter 2d_DR(Cụm trốn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]
2019-05-12 add 12 May 2019
    [Thong tin tai khoan.xlsx]
2019-05-30 Add database
    [Book1.xlsx]
